jayinfinia/archibald-moteus/hw/c1-encoder-review/Bench-Test-Record.csv

Test ID | Status | Date | Tester | Board revision | Firmware commit | Encoder model | Protocol | Cable length mm | Termination | Setup and acceptance criteria | Measurements | Evidence file links | Reviewer | Notes
D01 | NOT RUN
D02 | NOT RUN
D03 | NOT RUN
D04 | NOT RUN
D05 | NOT RUN
D06 | NOT RUN
D07 | NOT RUN
B01 | NOT RUN
B02 | NOT RUN
B03 | NOT RUN
B04 | NOT RUN
B05 | NOT RUN
B06 | NOT RUN
B07 | NOT RUN
B08 | NOT RUN
B09 | NOT RUN
B10 | NOT RUN
B11 | NOT RUN
B12 | NOT RUN
