jayinfinia/archibald-moteus/hw/c1-encoder-review/Verification.txt

Verification: 2026-10-08
PASS: 12 interface connection groups match intended mapping.
PASS: battery positive connects only J2.7 and J3.1.
PASS: no duplicate component references.
PASS: stock AUX2 and AUX2H1 removed from schematic.
PASS: all electrical connections among components outside aux2 are unchanged.
PASS: all other child schematic files are byte-identical to the original.
baseline ERC: {'error': 28, 'warning': 91}; total 119
integrated ERC: {'error': 24, 'warning': 65}; total 89
PASS: zero reported ERC violations on integrated aux2 sheet.
NOT VERIFIED: physical footprints, cable contact orientation, loaded power budget, PCB layout, firmware, hardware behavior.
ERC counts are not directly comparable for footprint warnings: baseline library resolution differs from the self-contained output copy. Existing C1 violations remain.
