jayinfinia/archibald-moteus/hw/c1-encoder-review/Complete-C1-Schematic.pdf

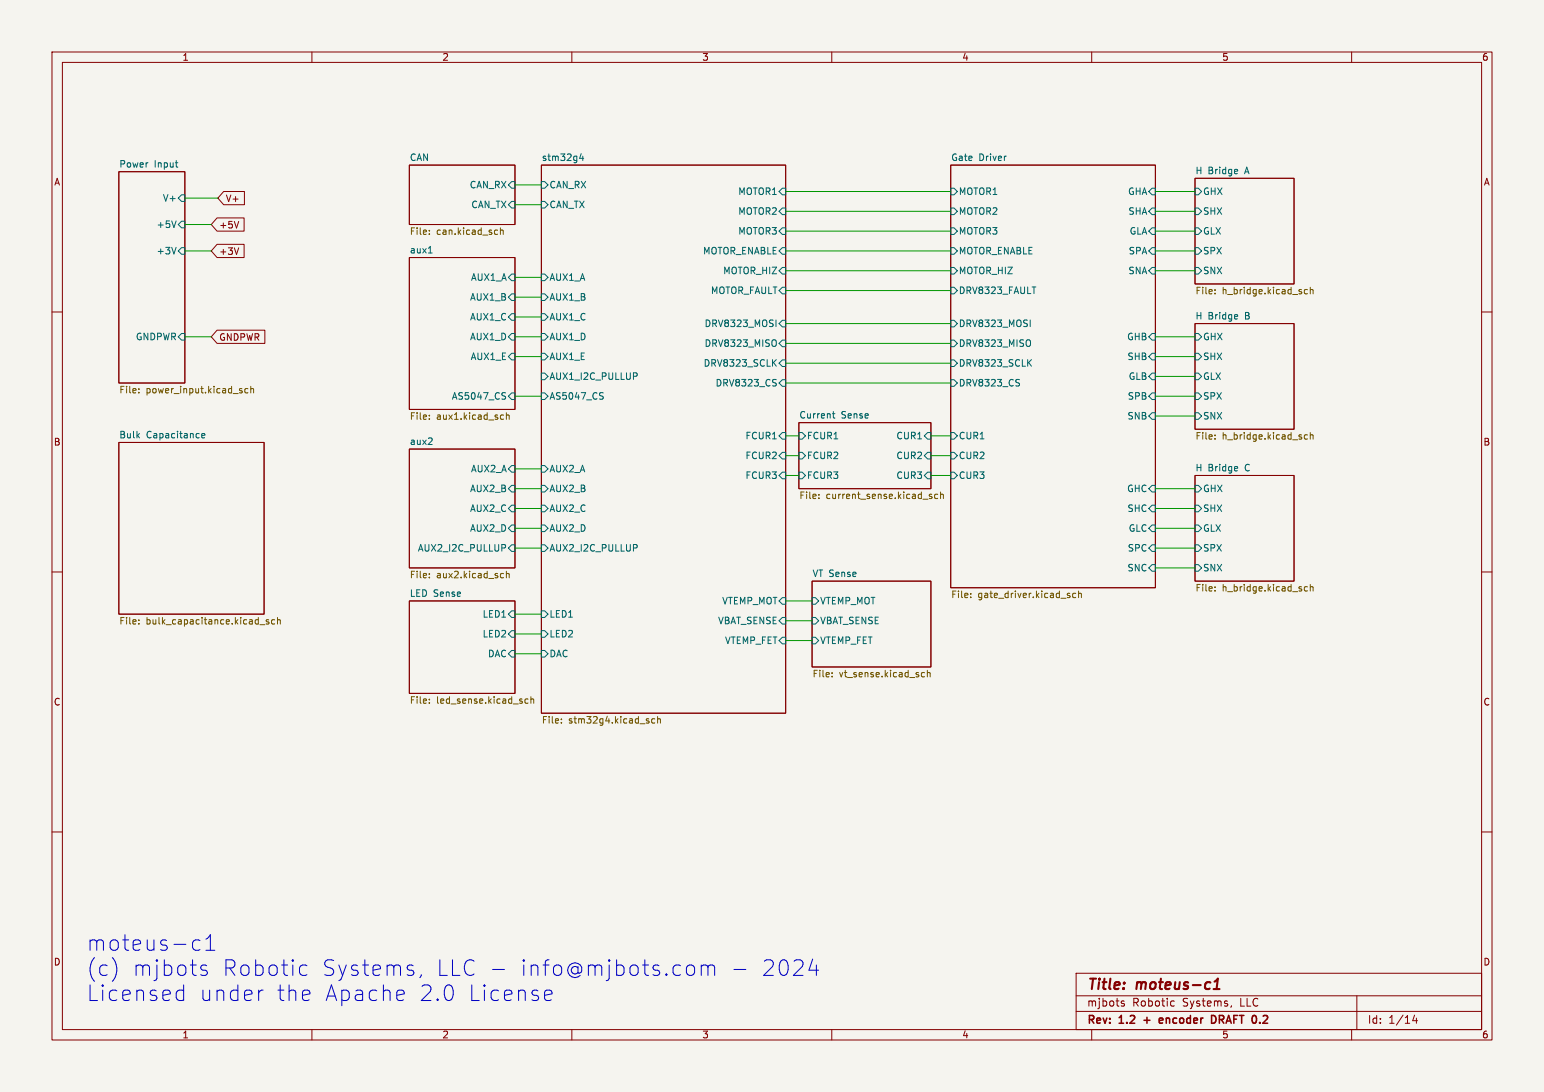
[picture p1: page 1]

Power Input File: power_input.kicad_sch +3V GNDPWR

Licensed under the Apache 2.0 License

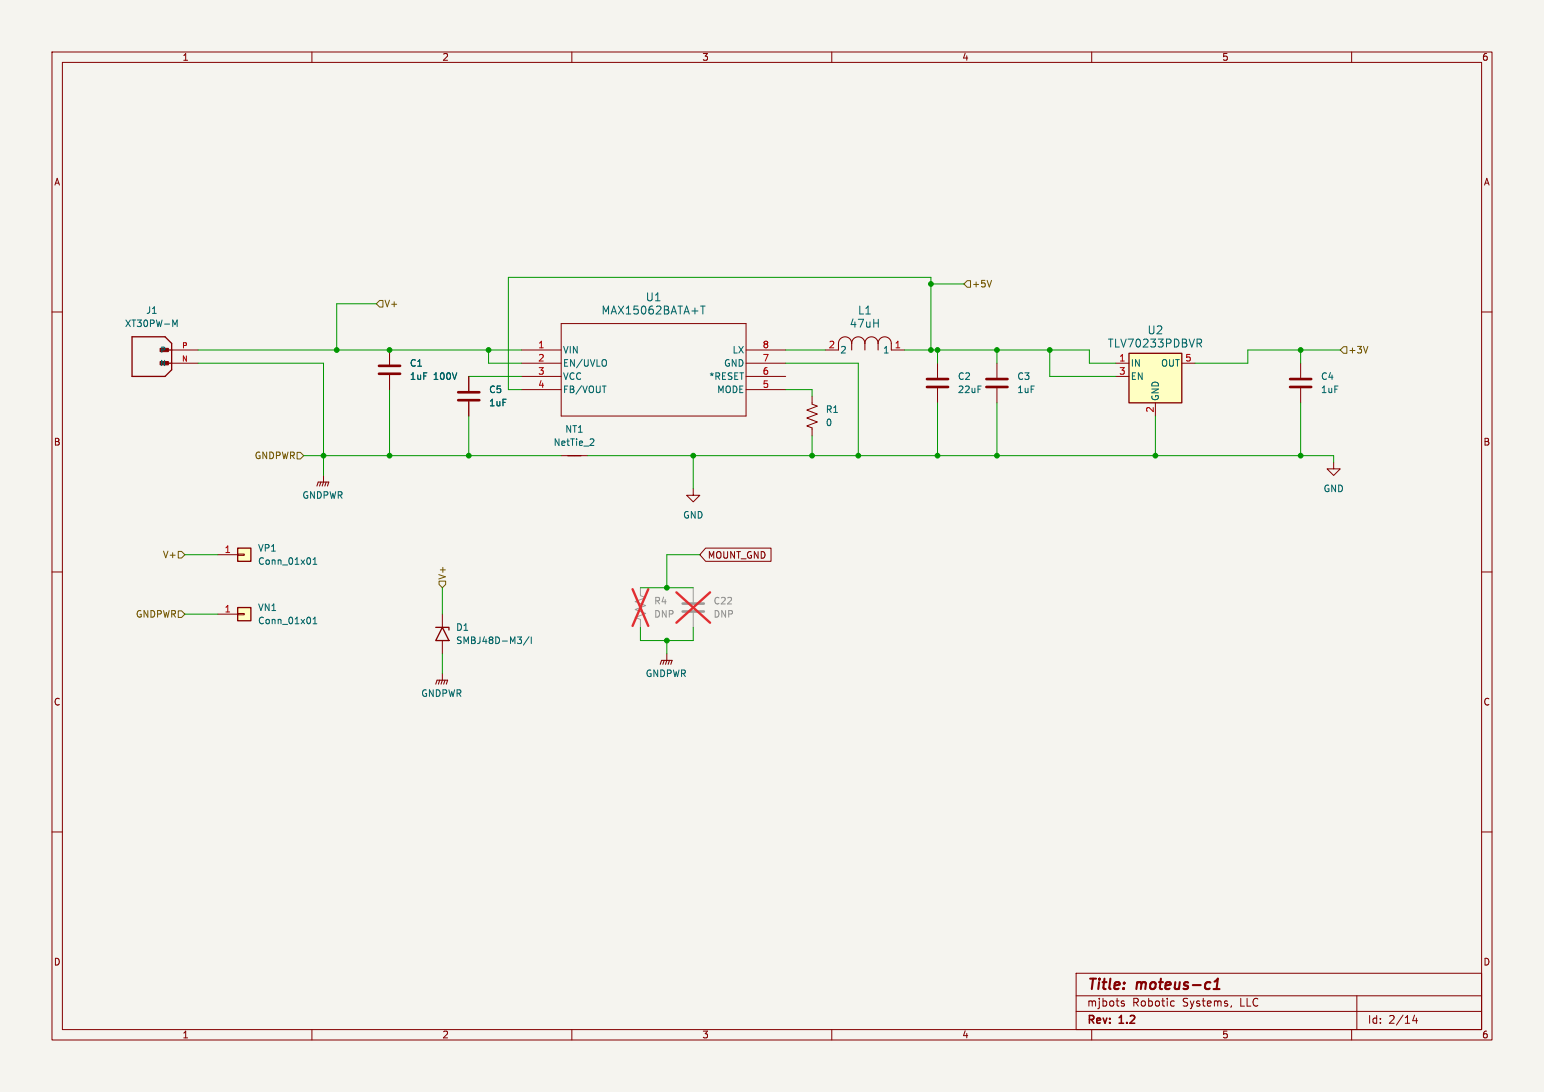
[picture p2: page 2]

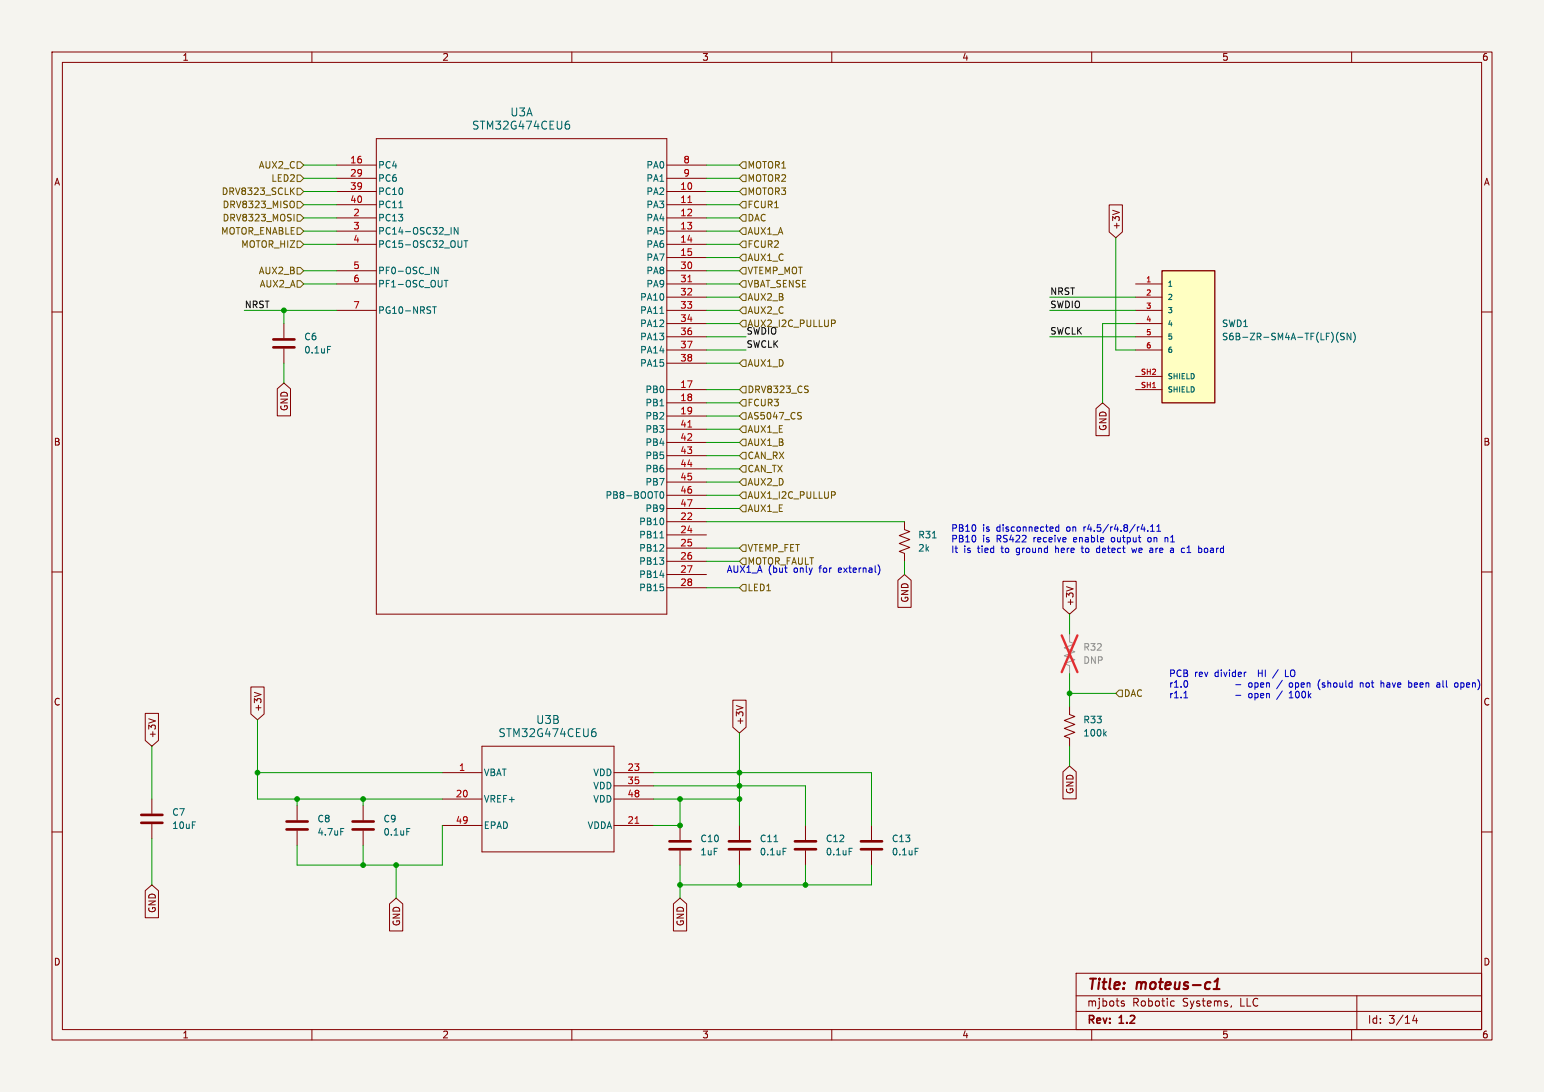
[picture p3: page 3]

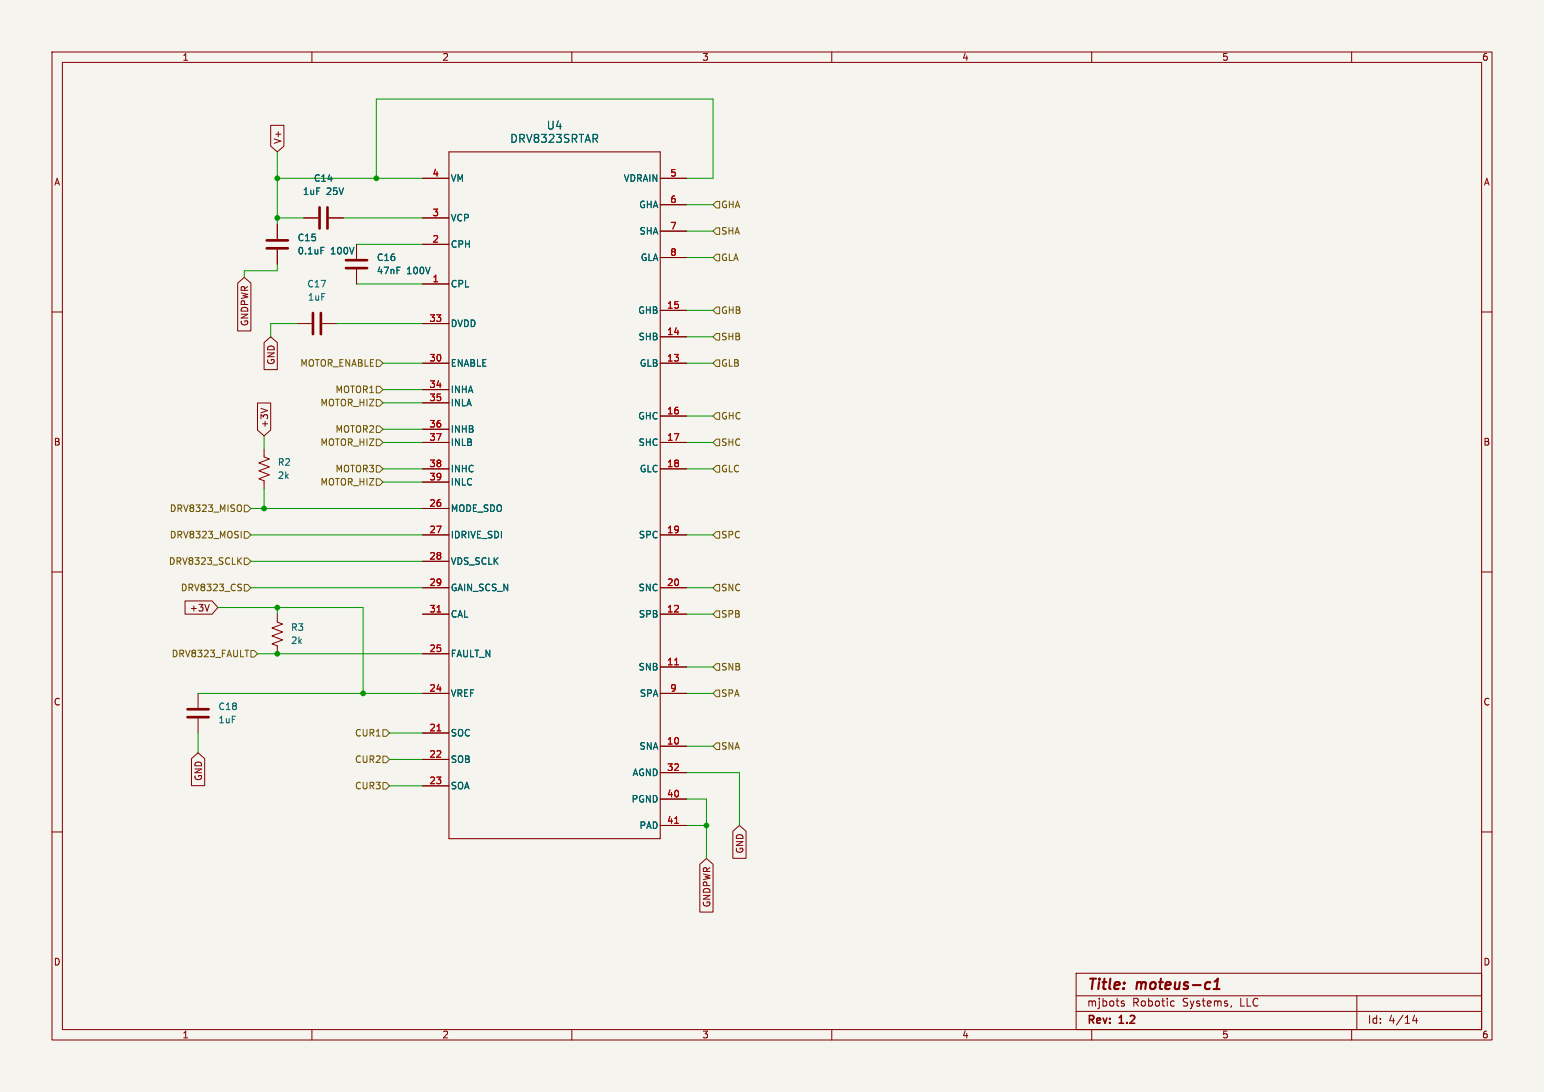
[picture p4: page 4]

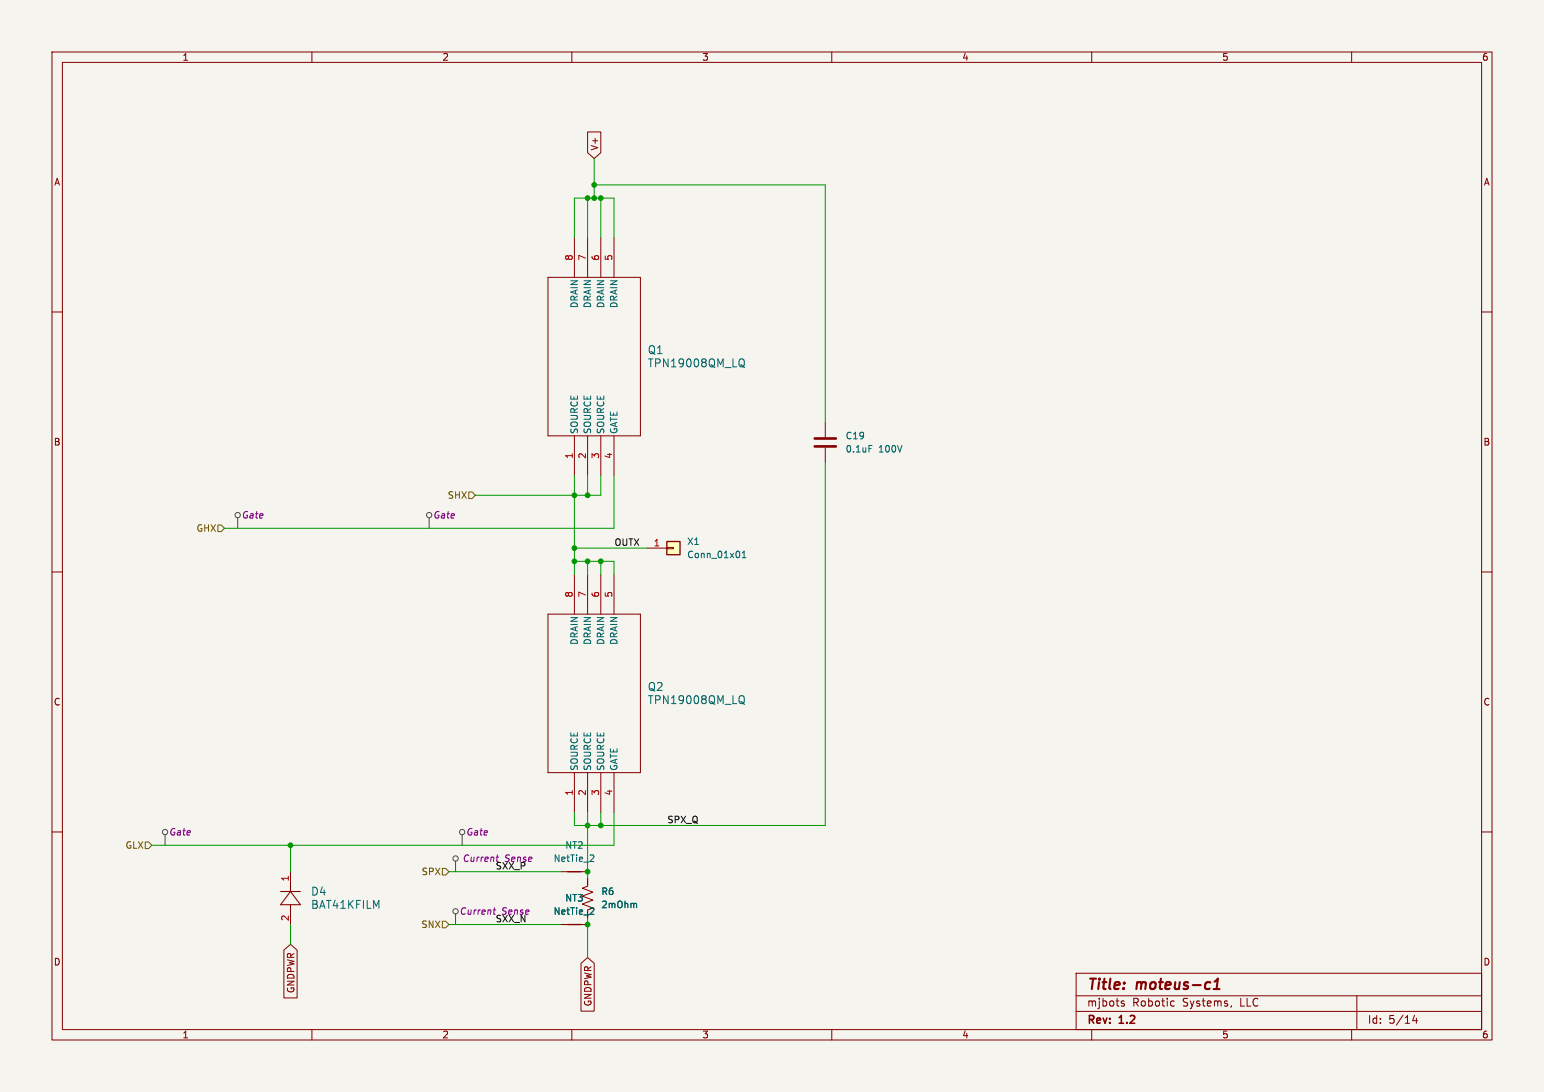
[picture p5: page 5]

2 1 D4BAT41KFILM Current Sense Current Sense Gate Gate Gate Gate SPX

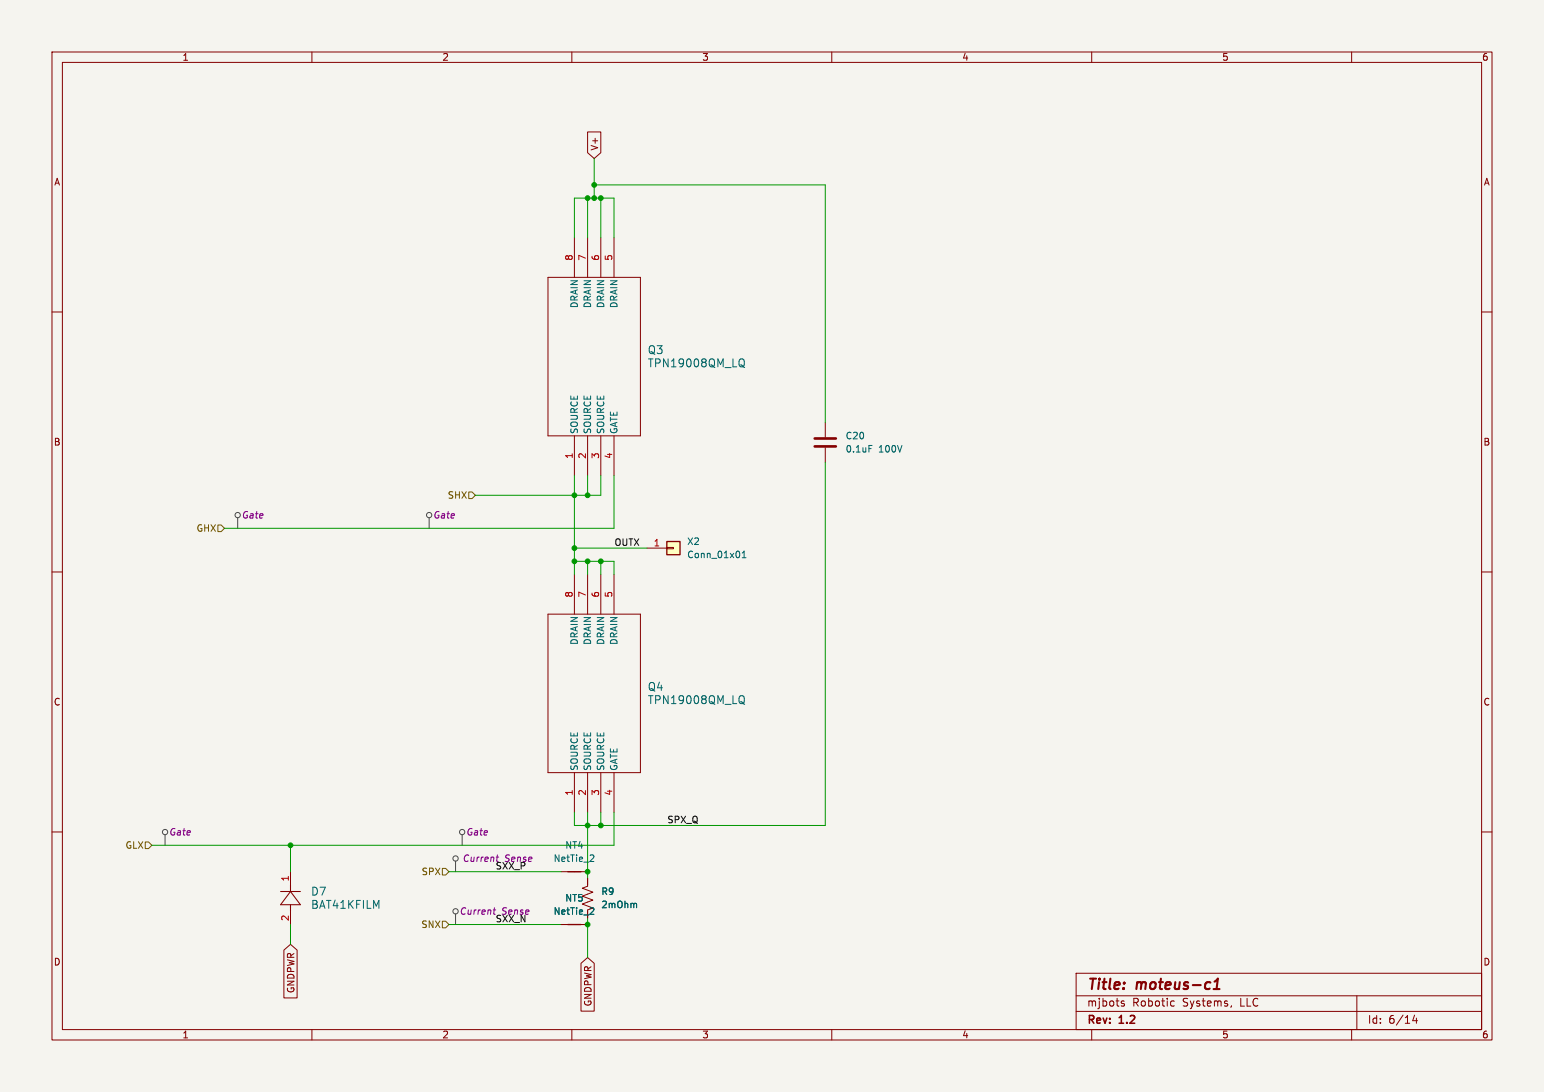
[picture p6: page 6]

2 1 D7BAT41KFILM Current Sense Current Sense Gate Gate Gate Gate SPX

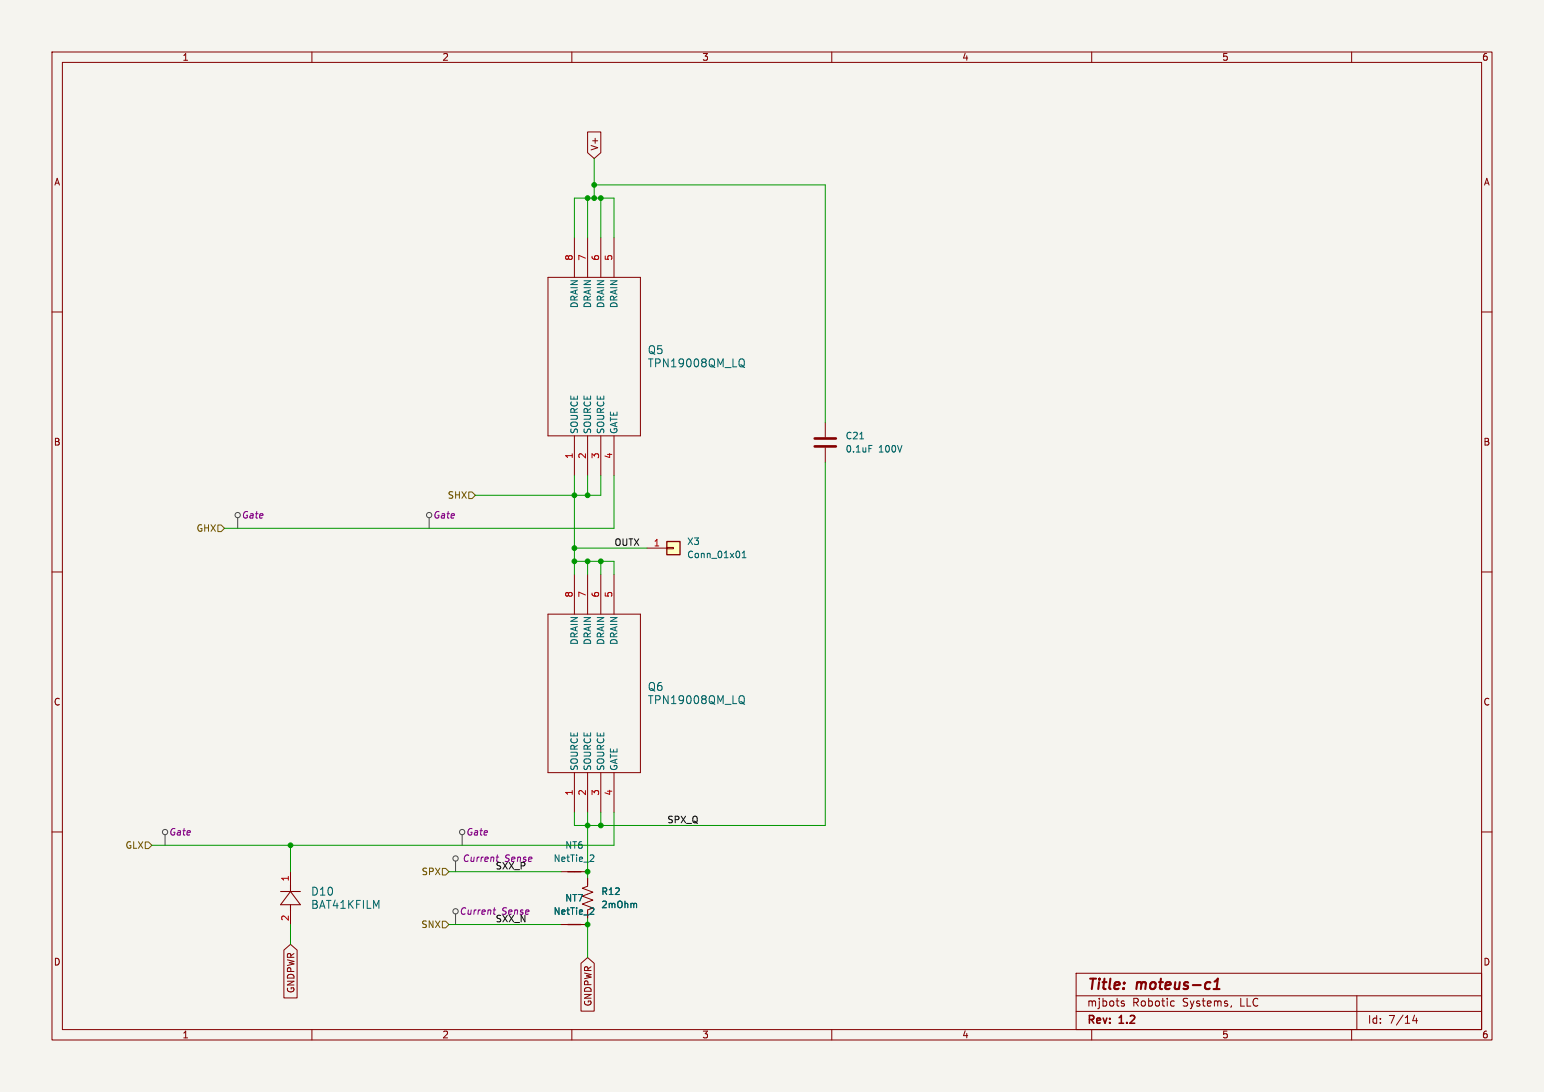
[picture p7: page 7]

2 1 D10 BAT41KFILM Current Sense Current Sense Gate Gate Gate Gate SPX

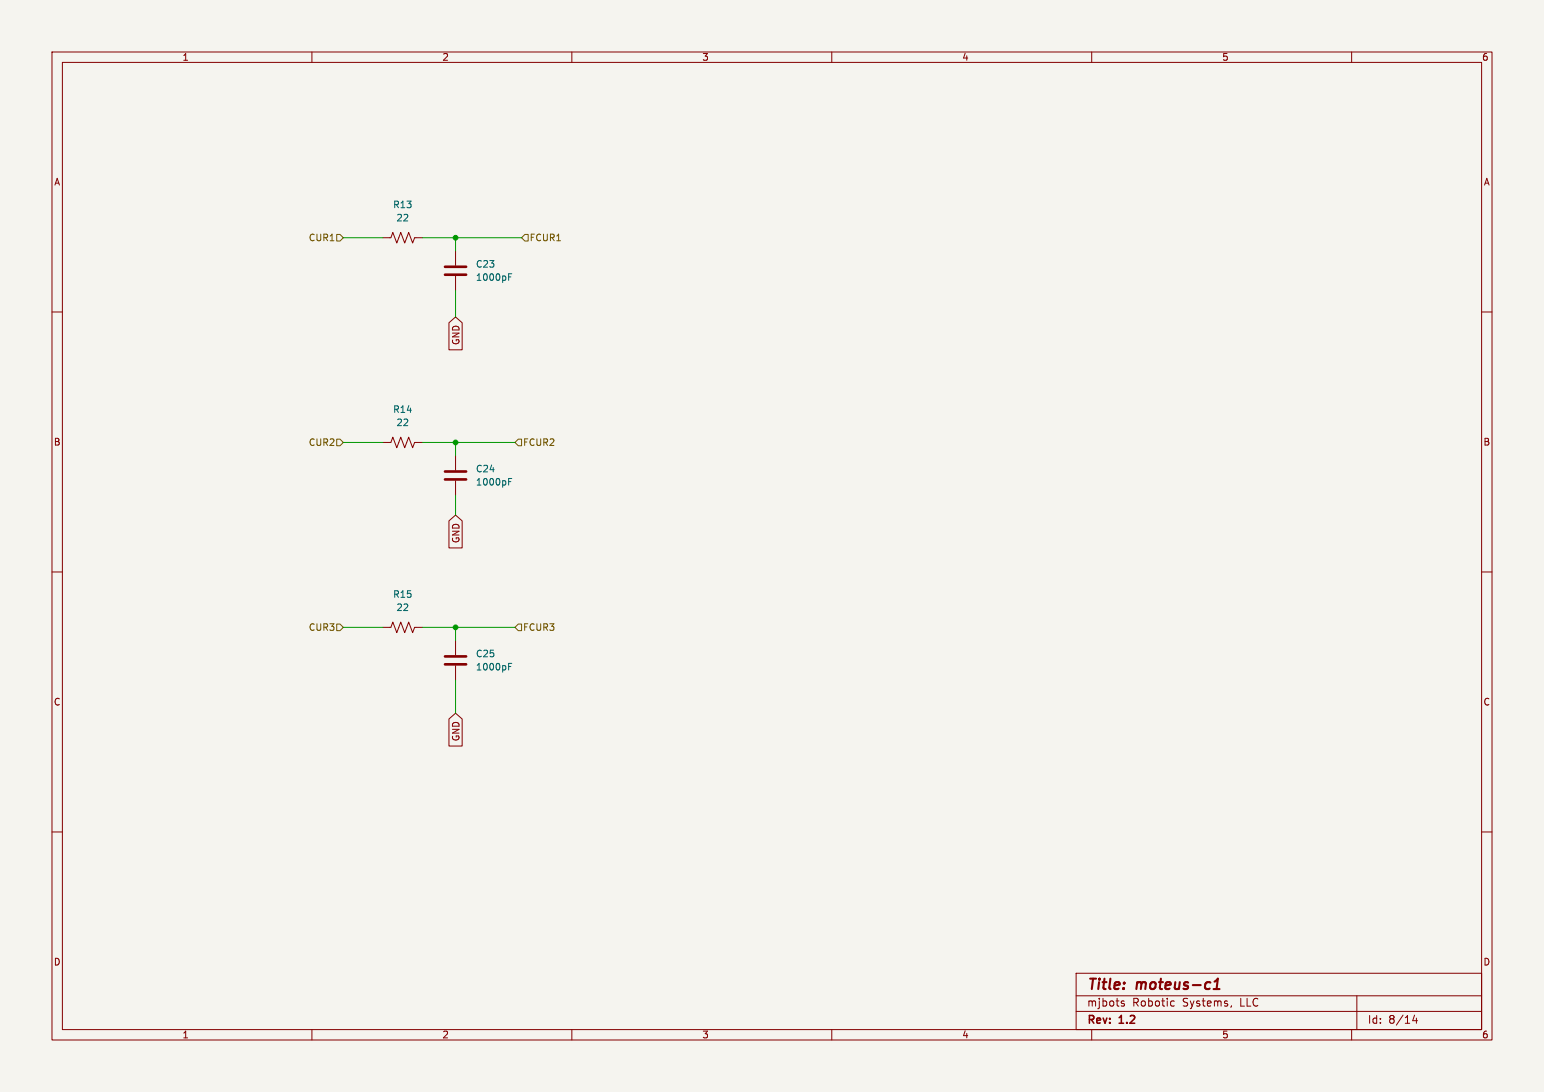
[picture p8: page 8]

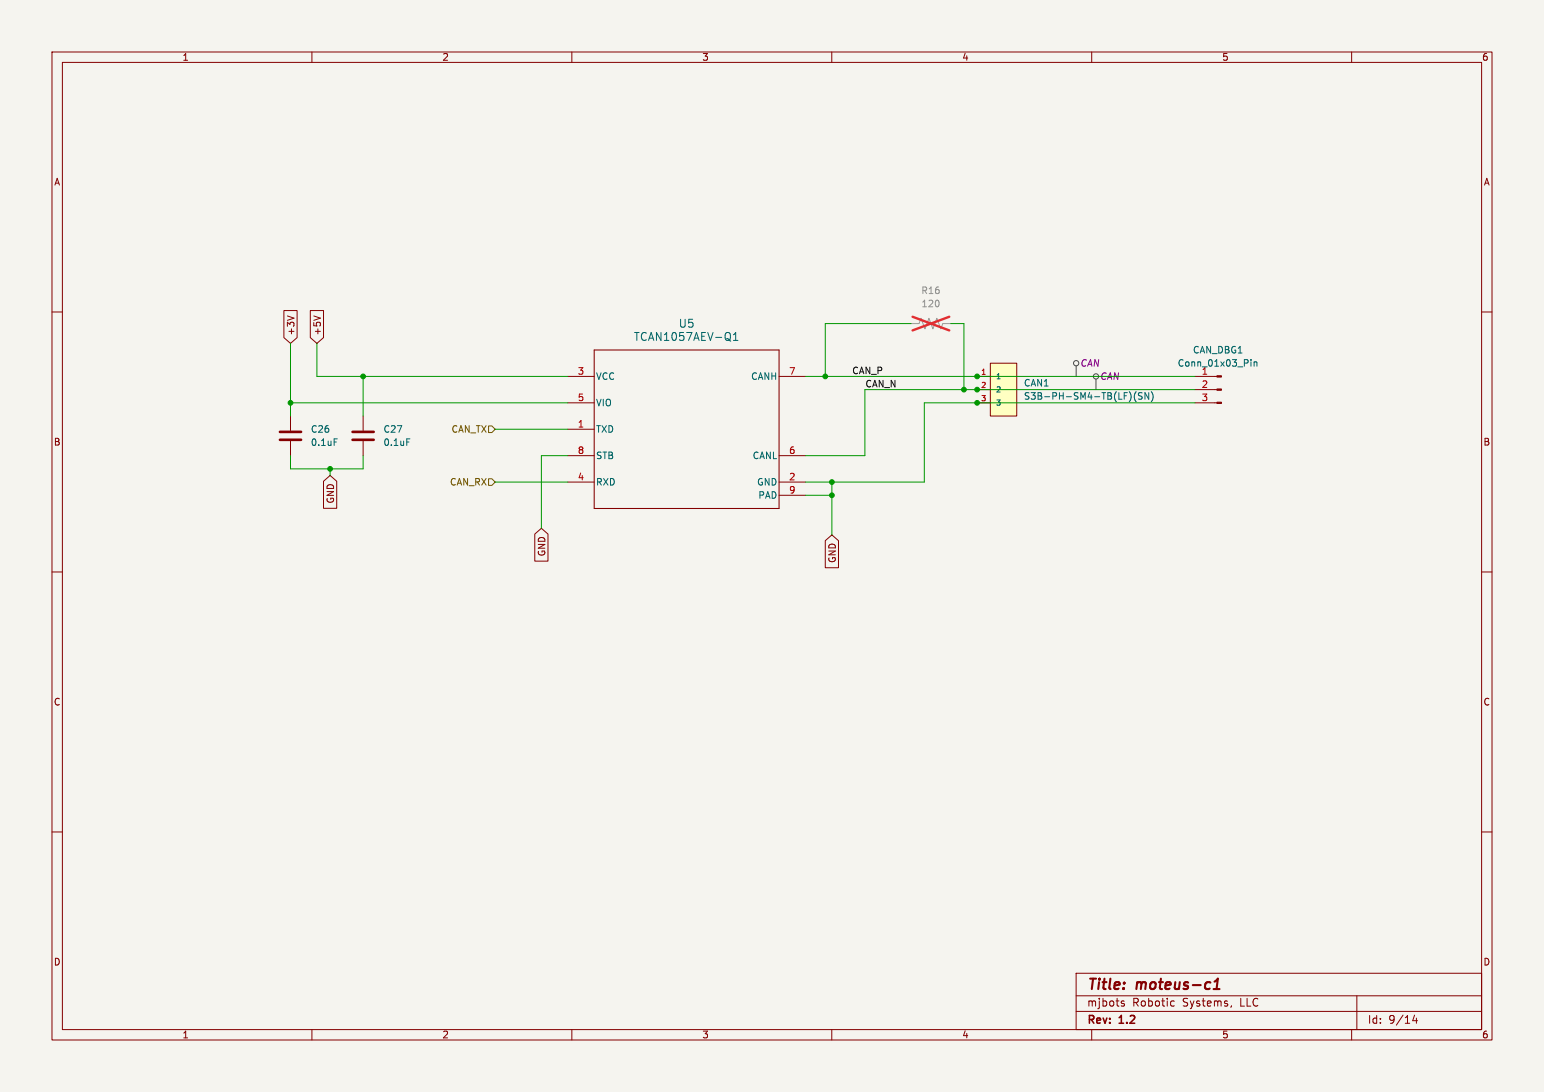
[picture p9: page 9]

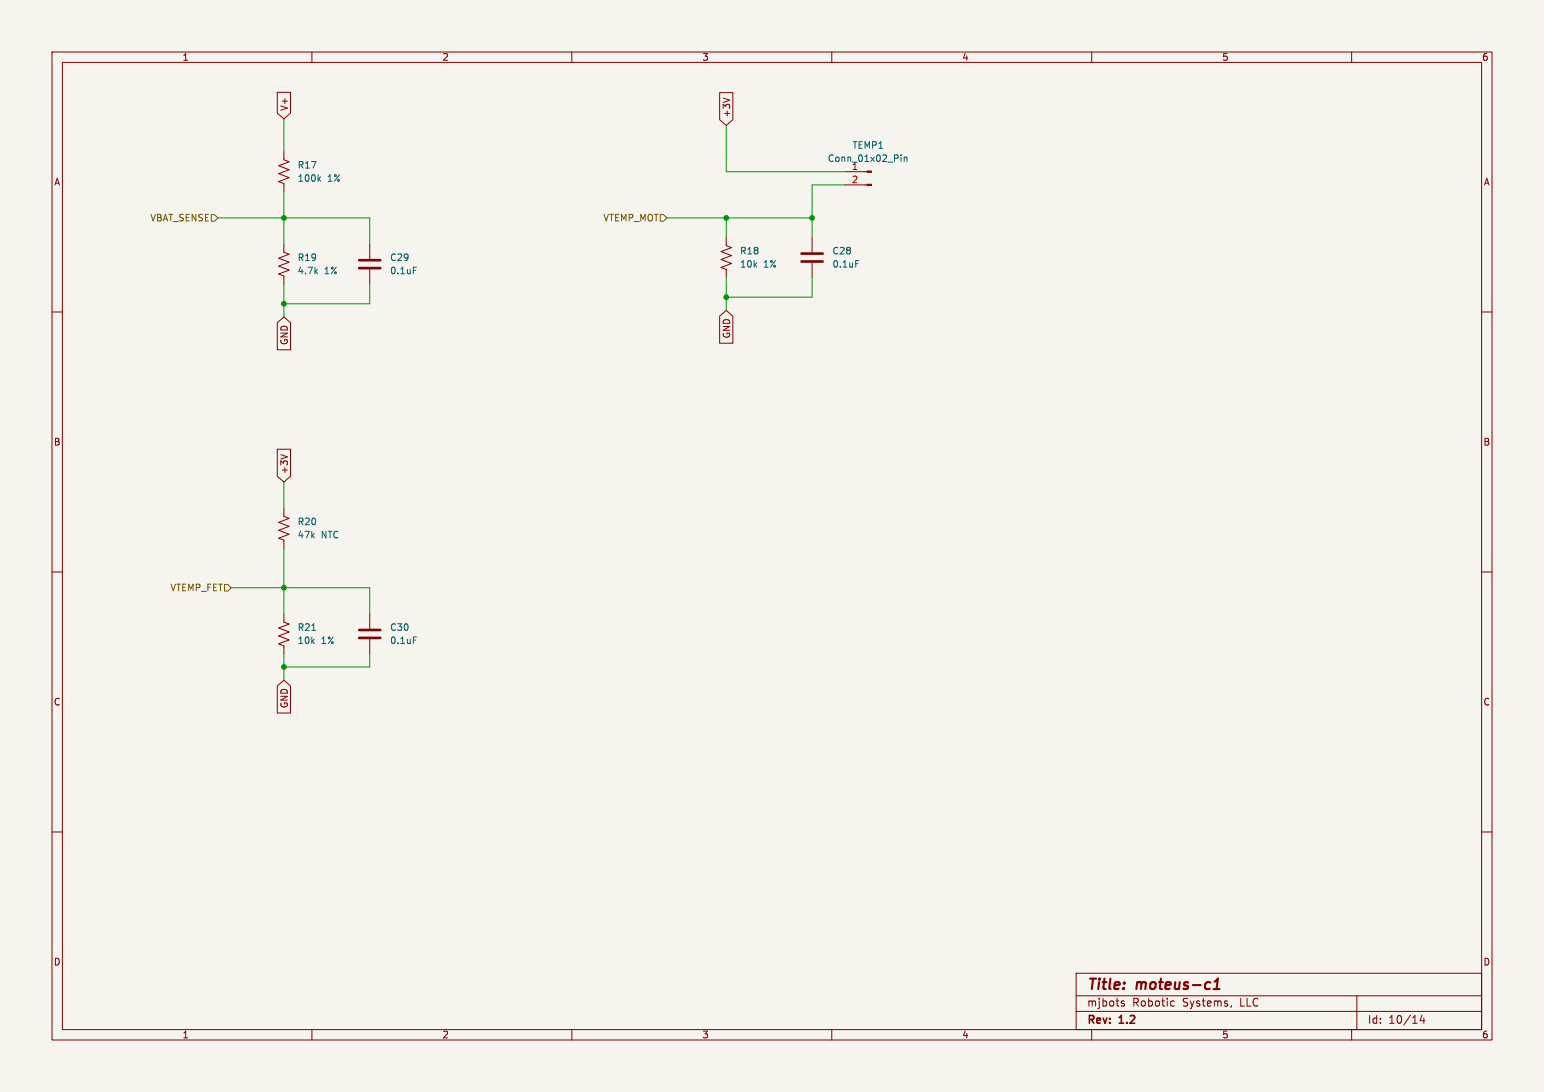
[picture p10: page 10]

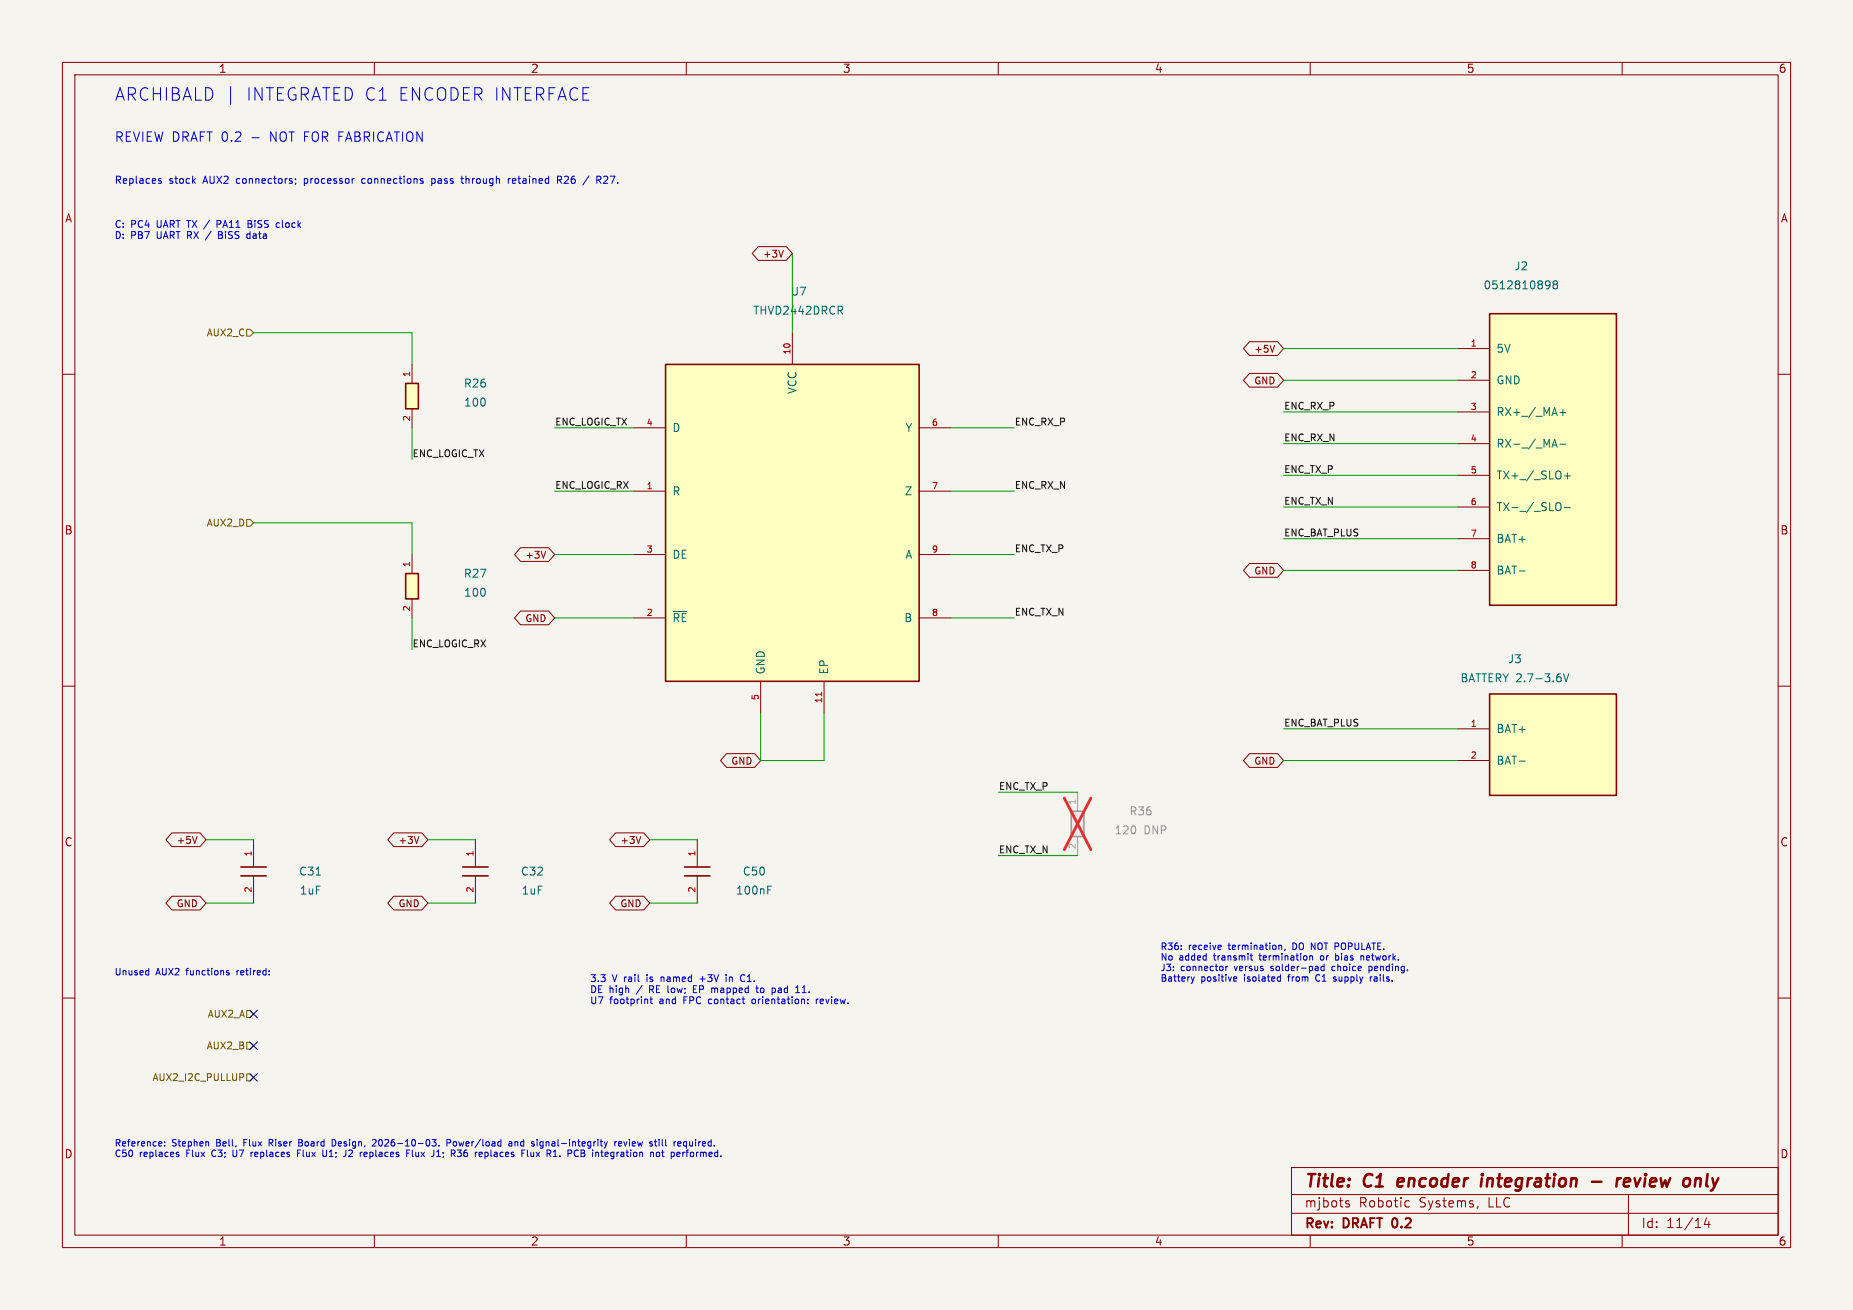
[picture p11: page 11]

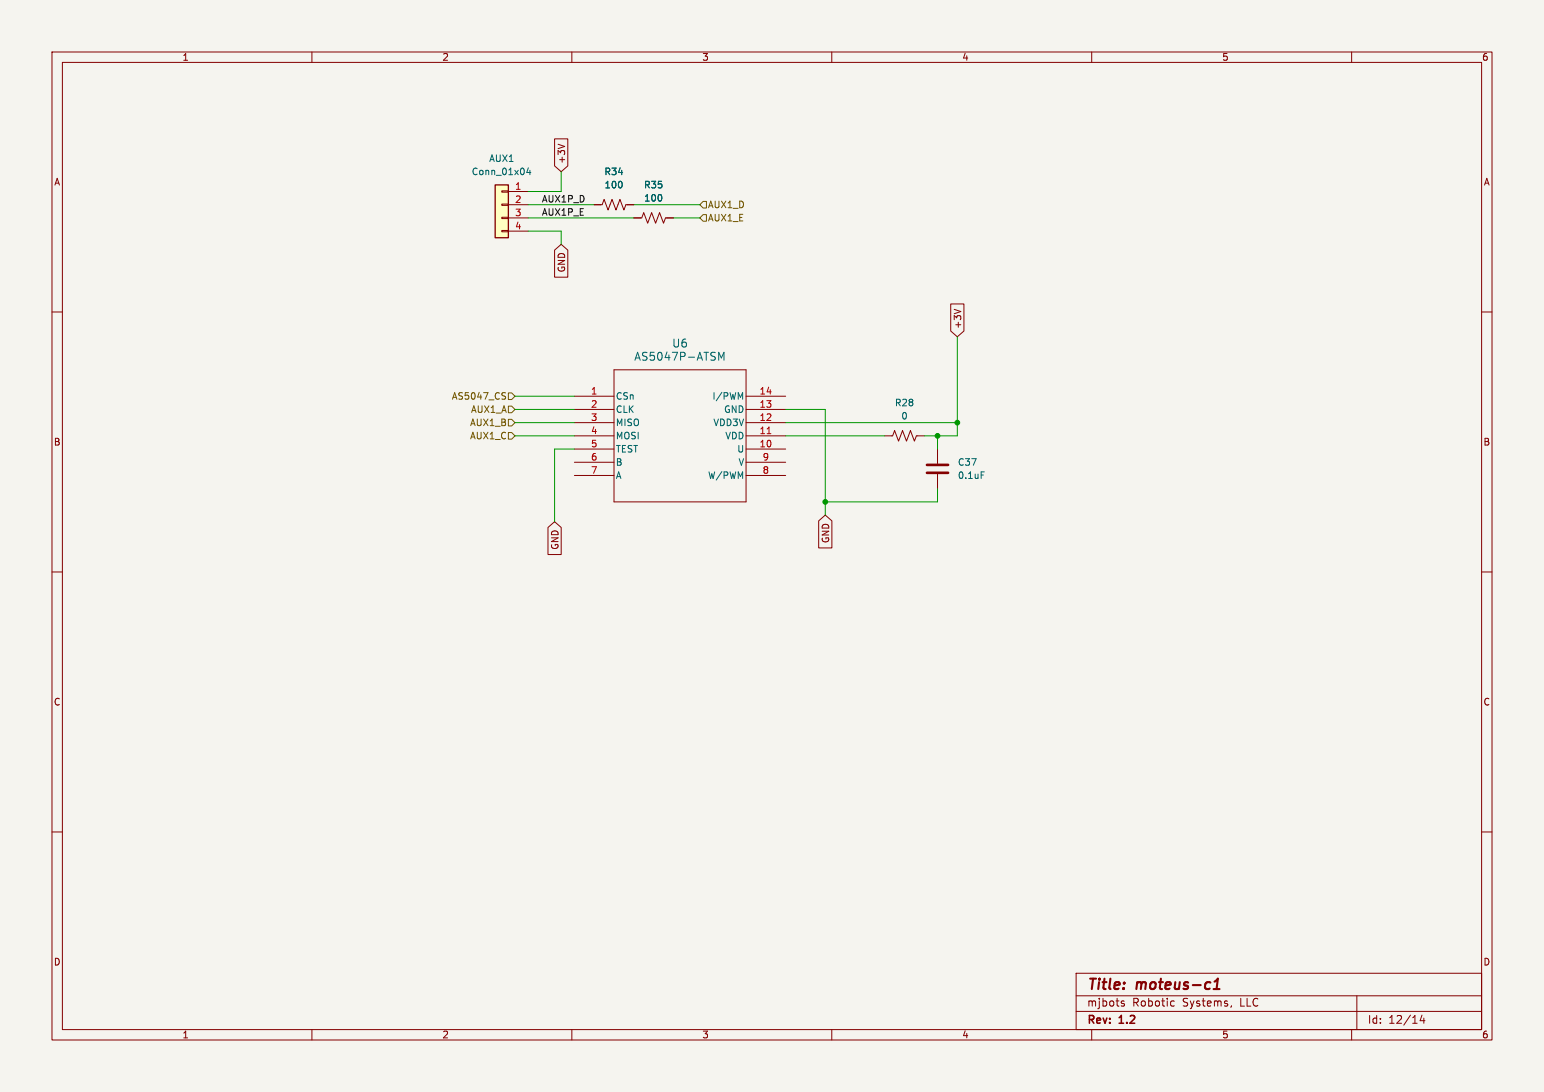
[picture p12: page 12]

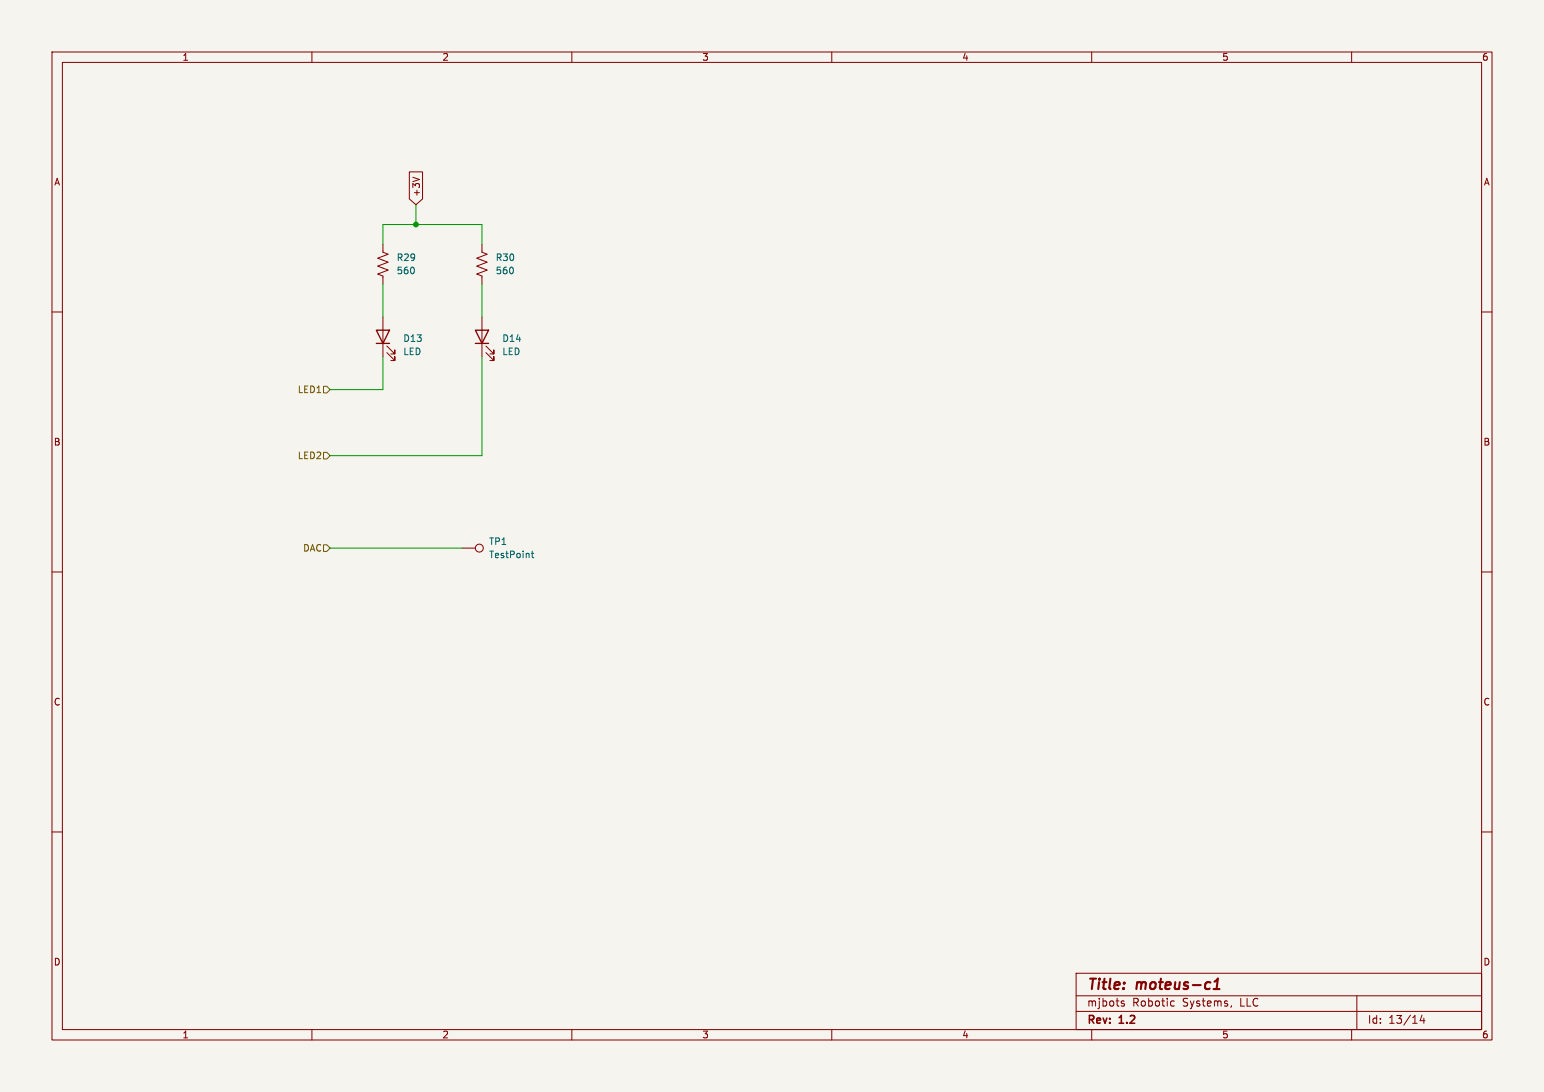
[picture p13: page 13]

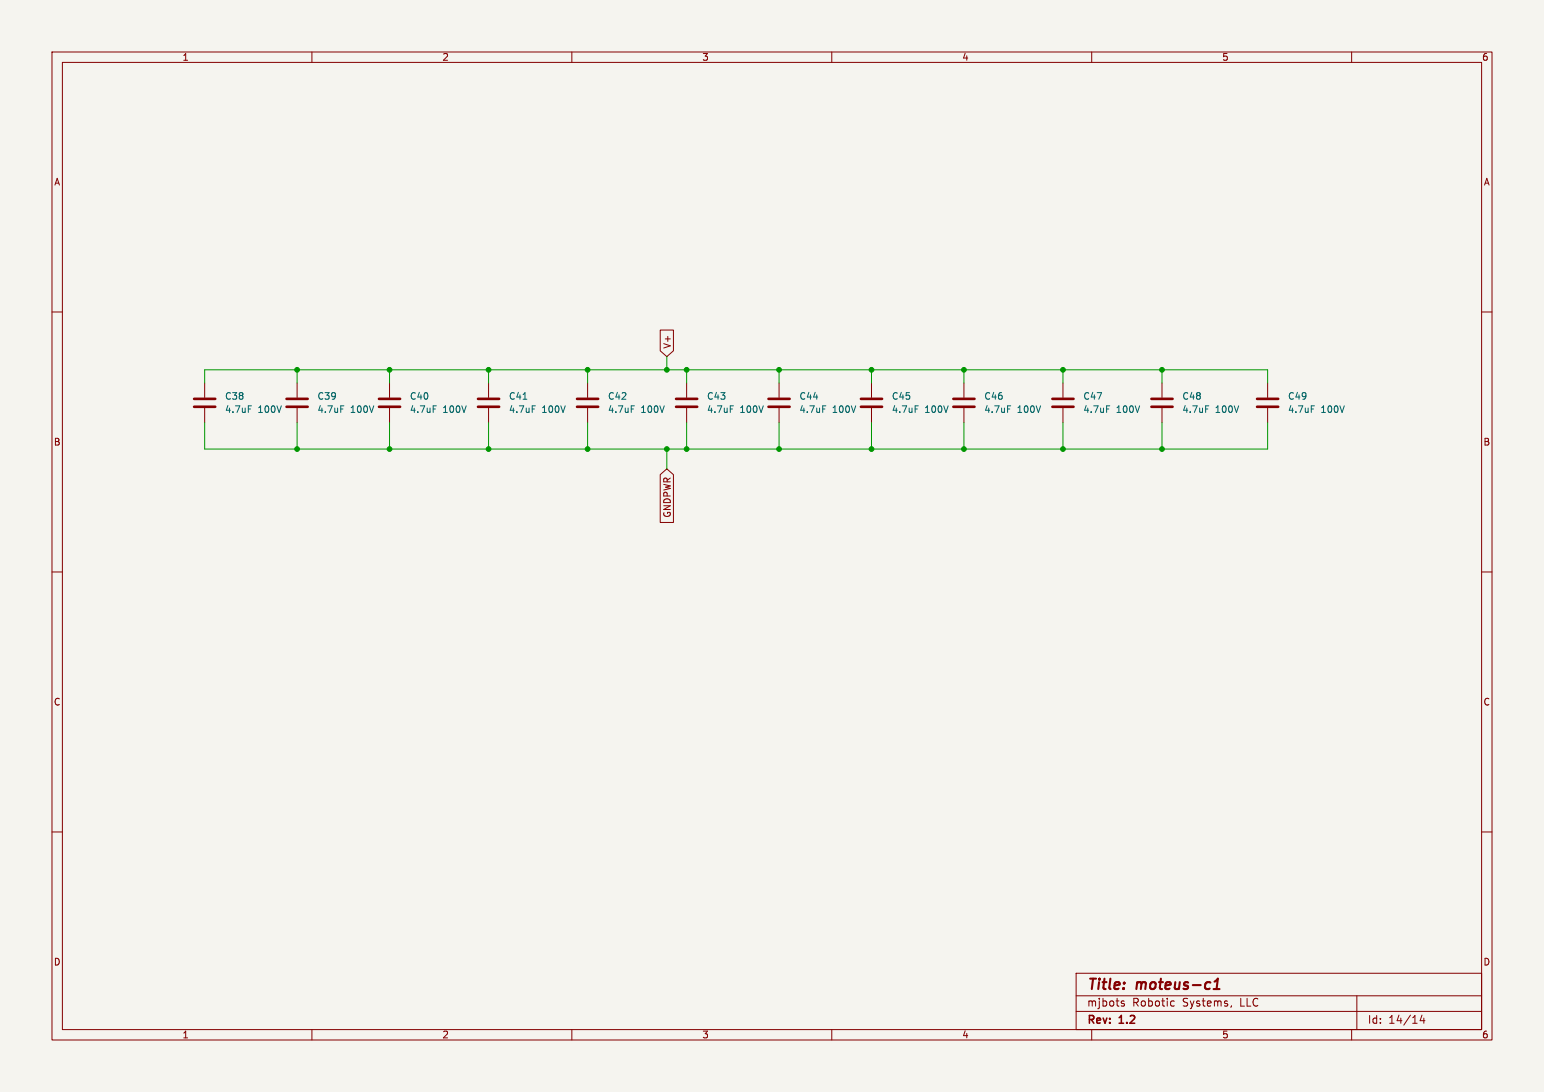
[picture p14: page 14]
