jayinfinia/archibald-moteus/hw/c1-encoder-review/aux1.kicad_sch

## KiCad design hw/c1-encoder-review/aux1.kicad_sch (2026-10-09)

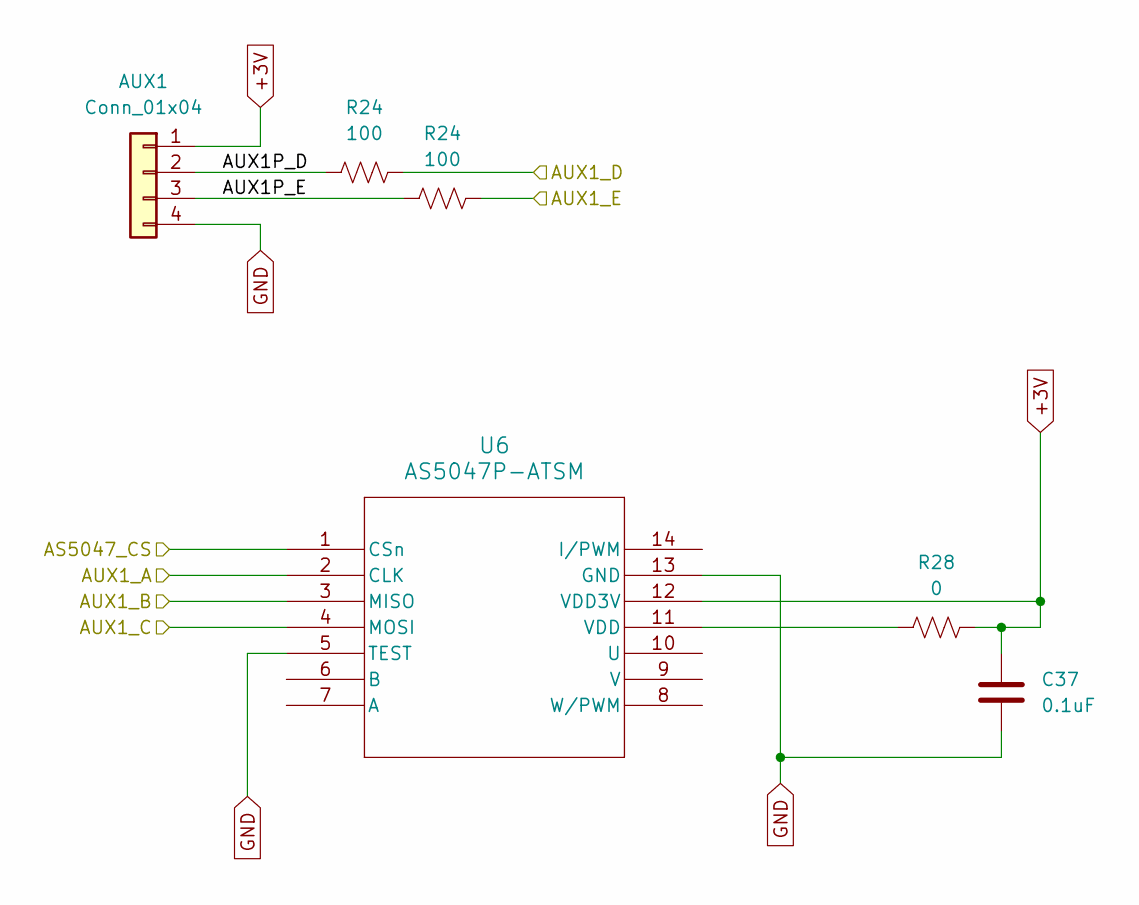
[picture p15: schematic aux1.kicad_sch]

Parts:
AUX1: Conn_01x04; PinHeader_1x04_P1.27mm_Vertical
C37: 0.1uF; C_0402_1005Metric; MPN MF-CAP-0402-0.1uF
R24: 100; R_0402_1005Metric; MPN MF-RES-0402-100
R28: 0; R_0402_1005Metric; MPN MF-RES-0402-0
U6: AS5047P-ATSM; TSSOP14_OSM; MPN AS5047P-ATSM

Connections:
+3V: AUX1.1, C37.1, R28.2, U6.12 (VDD3V)
AS5047_CS: U6.1 (CSn)
AUX1P_D: AUX1.2, R24.1
AUX1P_E: AUX1.3, R24.1
AUX1_A: U6.2 (CLK)
AUX1_B: U6.3 (MISO)
AUX1_C: U6.4 (MOSI)
AUX1_D: R24.2
AUX1_E: R24.2
GND: AUX1.4, C37.2, U6.5 (TEST), U6.13 (GND)
unnamed: R28.1, U6.11 (VDD)
