jayinfinia/archibald-moteus/hw/c1-encoder-review/aux2.kicad_sch

## KiCad design hw/c1-encoder-review/aux2.kicad_sch (2026-10-19)

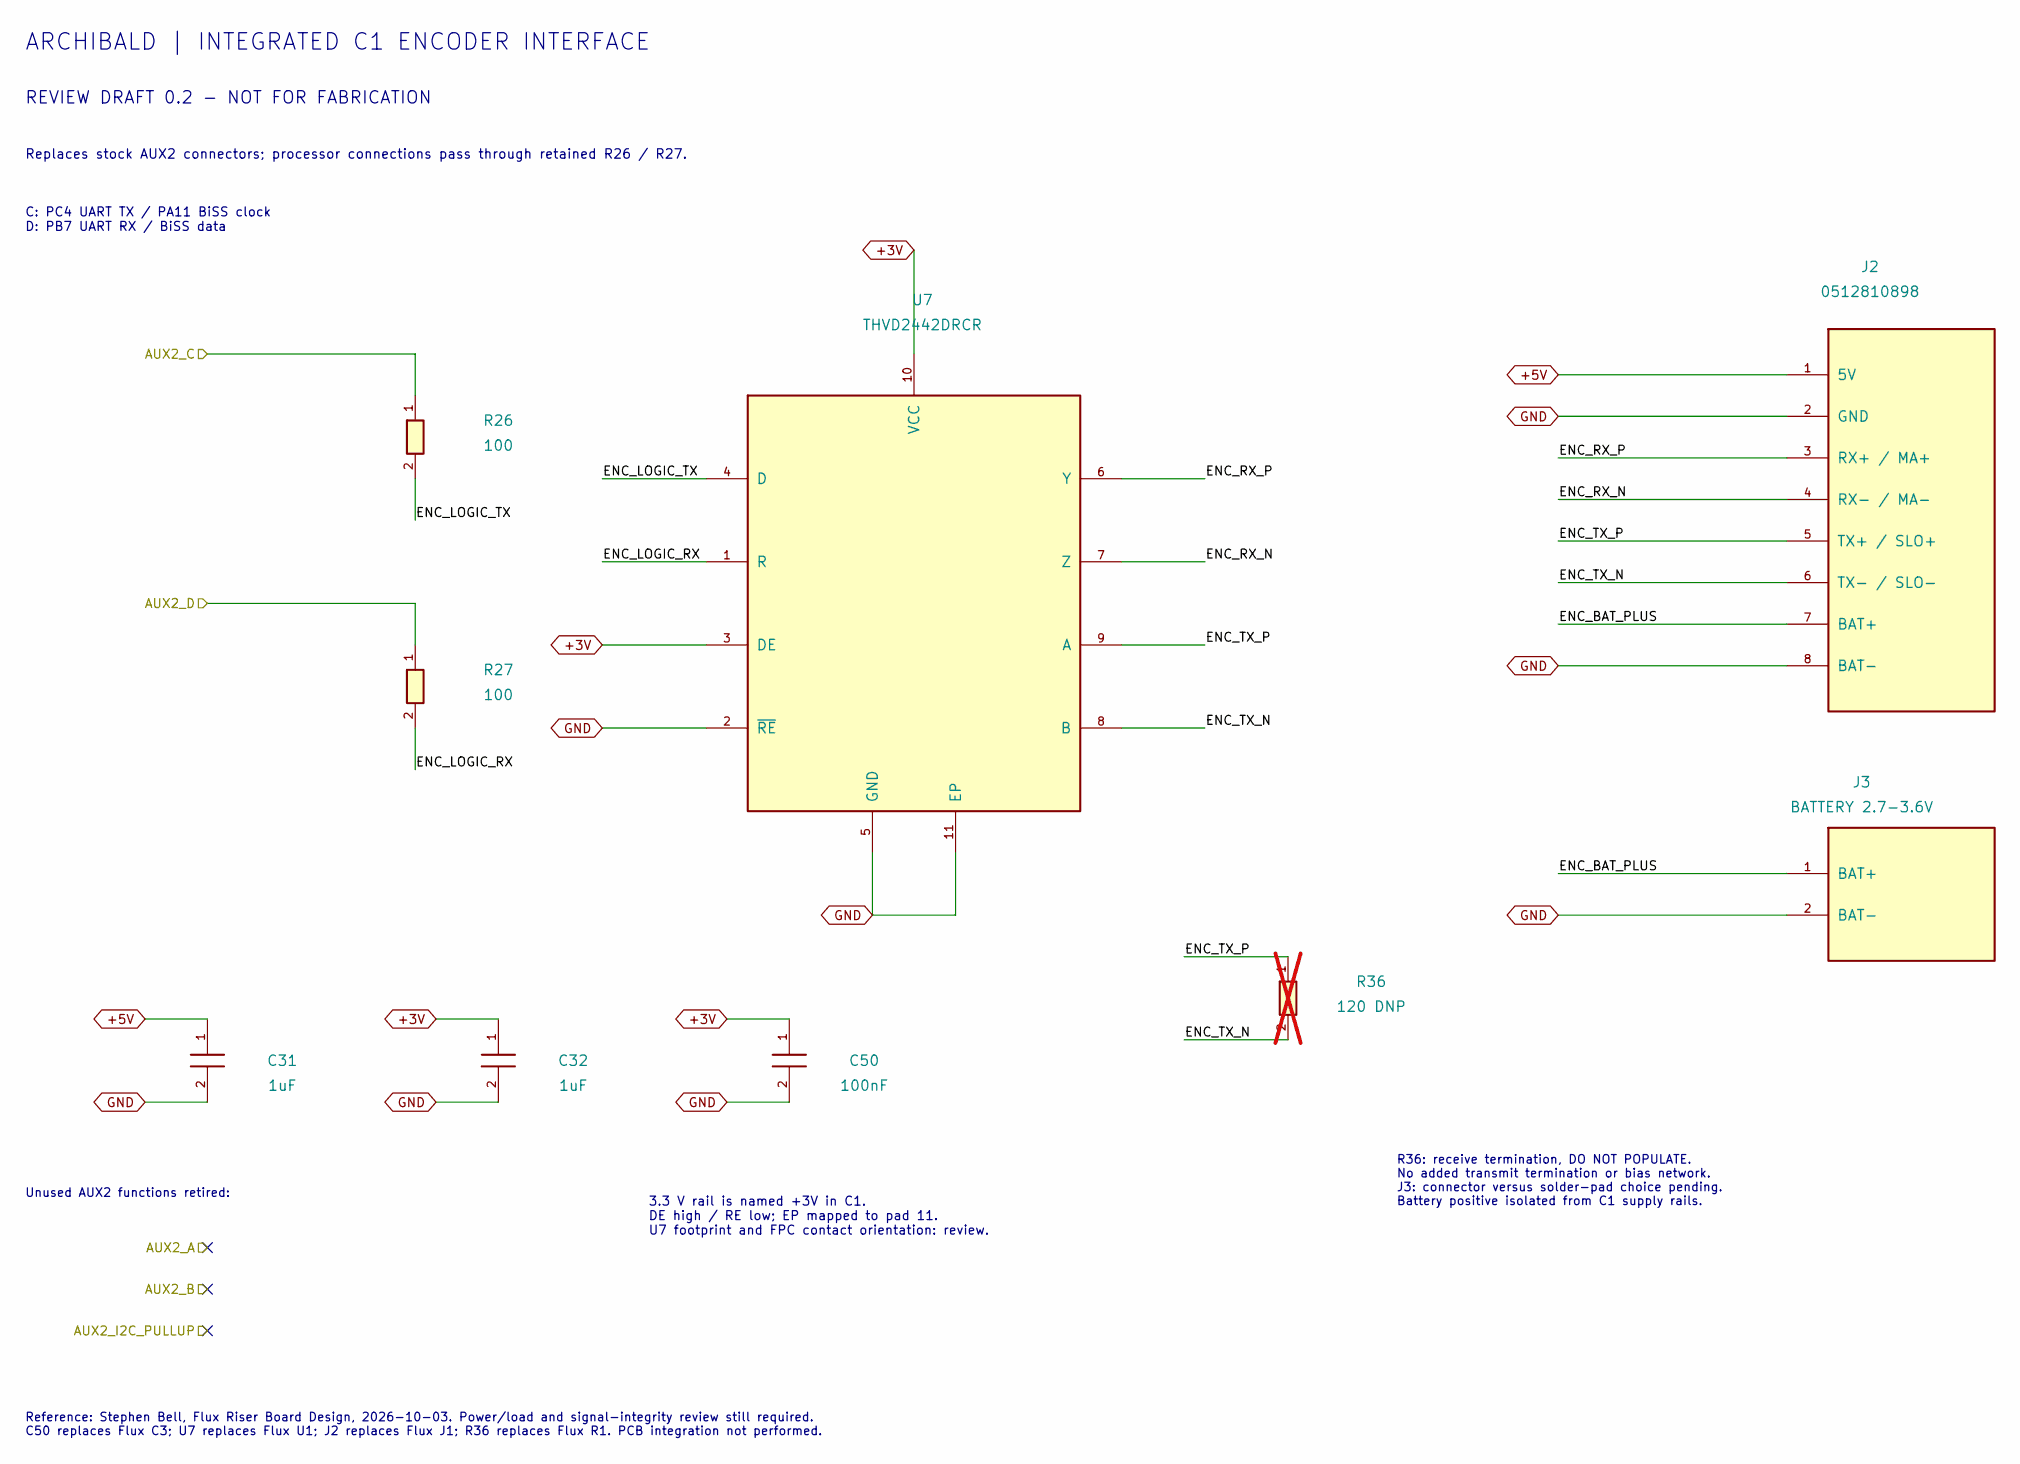
[picture p16: schematic aux2.kicad_sch]

Parts:
C31, C32: 1uF; C_0402_1005Metric
C50: 100nF; C_0402_1005Metric; MPN GRM155R61A104KA01D
J2: 0512810898; MPN 0512810898
J3: BATTERY 2.7-3.6V
R26, R27: 100; R_0402_1005Metric
R36: 120 DNP; R_0402_1005Metric; MPN RC0402FR-07120RL; not fitted
U7: THVD2442DRCR; TI_DRC0010J; MPN THVD2442DRCR

Connections:
+3V: C32.1, C50.1, U7.3 (DE), U7.10 (VCC)
+5V: C31.1, J2.1 (5V)
AUX2_C: R26.1
AUX2_D: R27.1
ENC_BAT_PLUS: J2.7 (BAT+), J3.1 (BAT+)
ENC_LOGIC_RX: R27.2, U7.1 (R)
ENC_LOGIC_TX: R26.2, U7.4 (D)
ENC_RX_N: J2.4 (RX- / MA-), U7.7 (Z)
ENC_RX_P: J2.3 (RX+ / MA+), U7.6 (Y)
ENC_TX_N: J2.6 (TX- / SLO-), R36.2, U7.8 (B)
ENC_TX_P: J2.5 (TX+ / SLO+), R36.1, U7.9 (A)
GND: C31.2, C32.2, C50.2, J2.2 (GND), J2.8 (BAT-), J3.2 (BAT-), U7.2 (~RE), U7.5 (GND), U7.11 (EP)

Notes on the sheet:
ARCHIBALD | INTEGRATED C1 ENCODER INTERFACE
REVIEW DRAFT 0.2 - NOT FOR FABRICATION
Replaces stock AUX2 connectors; processor connections pass through retained R26 / R27.
C: PC4 UART TX / PA11 BiSS clock D: PB7 UART RX / BiSS data
3.3 V rail is named +3V in C1. DE high / RE low; EP mapped to pad 11. U7 footprint and FPC contact orientation: review.
R36: receive termination, DO NOT POPULATE. No added transmit termination or bias network. J3: connector versus solder-pad choice pending. Battery positive isolated from C1 supply rails.
Unused AUX2 functions retired:
Reference: Stephen Bell, Flux Riser Board Design, 2026-10-03. Power/load and signal-integrity review still required. C50 replaces Flux C3; U7 replaces Flux U1; J2 replaces Flux J1; R36 replaces Flux R1. PCB integration not performed.
