jayinfinia/archibald-moteus/hw/c1-encoder-review/bulk_capacitance.kicad_sch

## KiCad design hw/c1-encoder-review/bulk_capacitance.kicad_sch (2026-10-09)

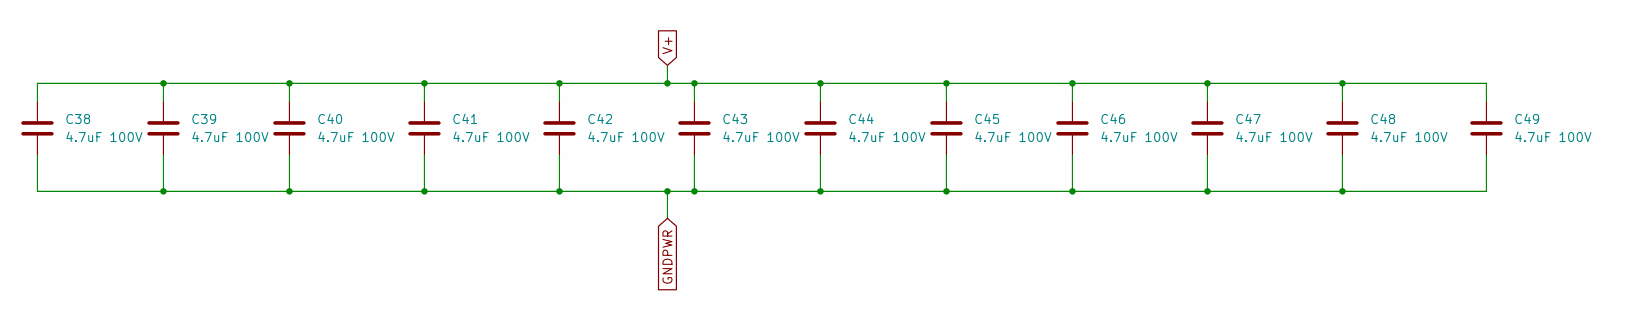
[picture p17: schematic bulk_capacitance.kicad_sch]

Parts:
C38, C39, C40, C41, C42, C43, C44, C45, C46, C47, C48, C49: 4.7uF 100V; C_1206_3216Metric; MPN GRJ31CC72A475KE01K

Connections:
GNDPWR: C38.2, C39.2, C40.2, C41.2, C42.2, C43.2, C44.2, C45.2, C46.2, C47.2, C48.2, C49.2
V+: C38.1, C39.1, C40.1, C41.1, C42.1, C43.1, C44.1, C45.1, C46.1, C47.1, C48.1, C49.1
