jayinfinia/archibald-moteus/hw/c1-encoder-review/can.kicad_sch

## KiCad design hw/c1-encoder-review/can.kicad_sch (2026-10-09)

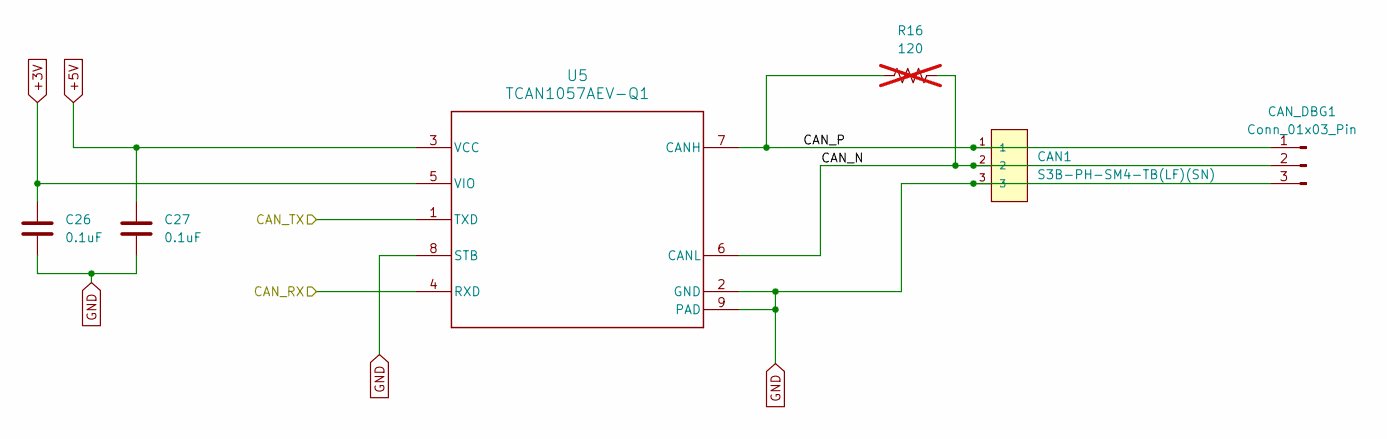
[picture p18: schematic can.kicad_sch]

Parts:
C26, C27: 0.1uF; C_0402_1005Metric; MPN MF-CAP-0402-0.1uF
CAN1: S3B-PH-SM4-TB(LF)(SN); JST_S3B-PH-SM4-TB(LF)(SN); MPN S3B-PH-SM4-TB(LF)(SN)
CAN_DBG1: Conn_01x03_Pin; PinHeader_1x03_P2.00mm_Vertical
R16: 120; R_0603_1608Metric; MPN RC0805FR-07120RL; not fitted
U5: TCAN1057AEV-Q1; SOIC-8_3.9x4.9mm_P1.27mm; MPN TCAN1057AEVDRQ1

Connections:
+3V: C26.1, U5.5 (VIO)
+5V: C27.1, U5.3 (VCC)
CAN_N: CAN1.2, CAN_DBG1.2, R16.2, U5.6 (CANL)
CAN_P: CAN1.1, CAN_DBG1.1, R16.1, U5.7 (CANH)
CAN_RX: U5.4 (RXD)
CAN_TX: U5.1 (TXD)
GND: C26.2, C27.2, CAN1.3, CAN_DBG1.3, U5.2 (GND), U5.8 (STB), U5.9 (PAD)
