jayinfinia/archibald-moteus/hw/c1-encoder-review/current_sense.kicad_sch

## KiCad design hw/c1-encoder-review/current_sense.kicad_sch (2026-10-09)

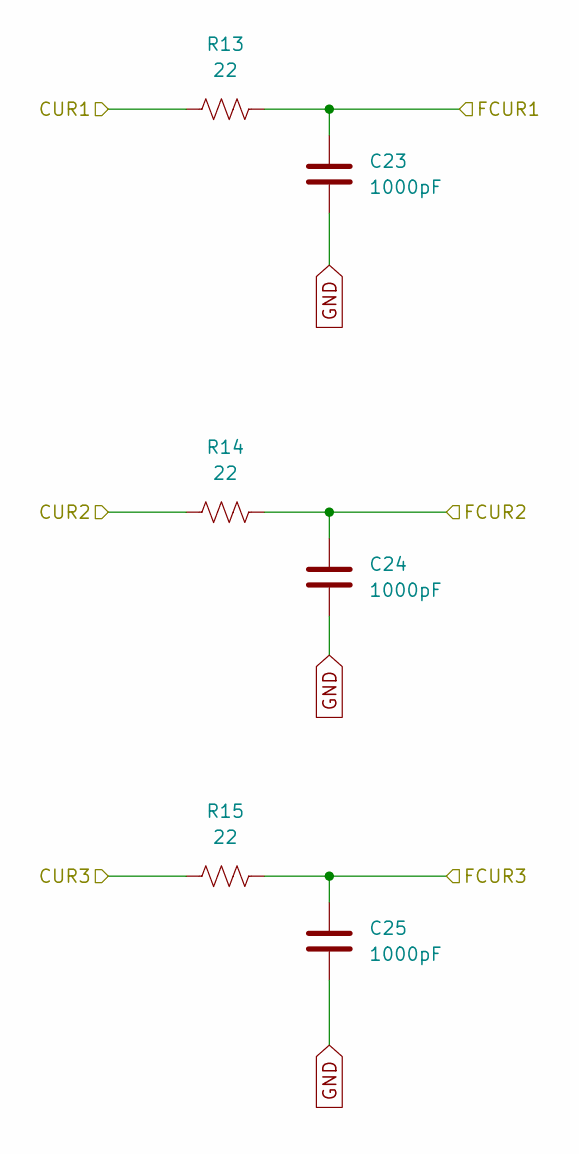
[picture p19: schematic current_sense.kicad_sch]

Parts:
C23, C24, C25: 1000pF; C_0402_1005Metric; MPN MF-CAP-0402-1nF
R13, R14, R15: 22; R_0402_1005Metric; MPN MF-RES-0402-22

Connections:
CUR1: R13.1
CUR2: R14.1
CUR3: R15.1
FCUR1: C23.1, R13.2
FCUR2: C24.1, R14.2
FCUR3: C25.1, R15.2
GND: C23.2, C24.2, C25.2
