jayinfinia/archibald-moteus/hw/c1-encoder-review/gate_driver.kicad_sch

## KiCad design hw/c1-encoder-review/gate_driver.kicad_sch (2026-10-09)

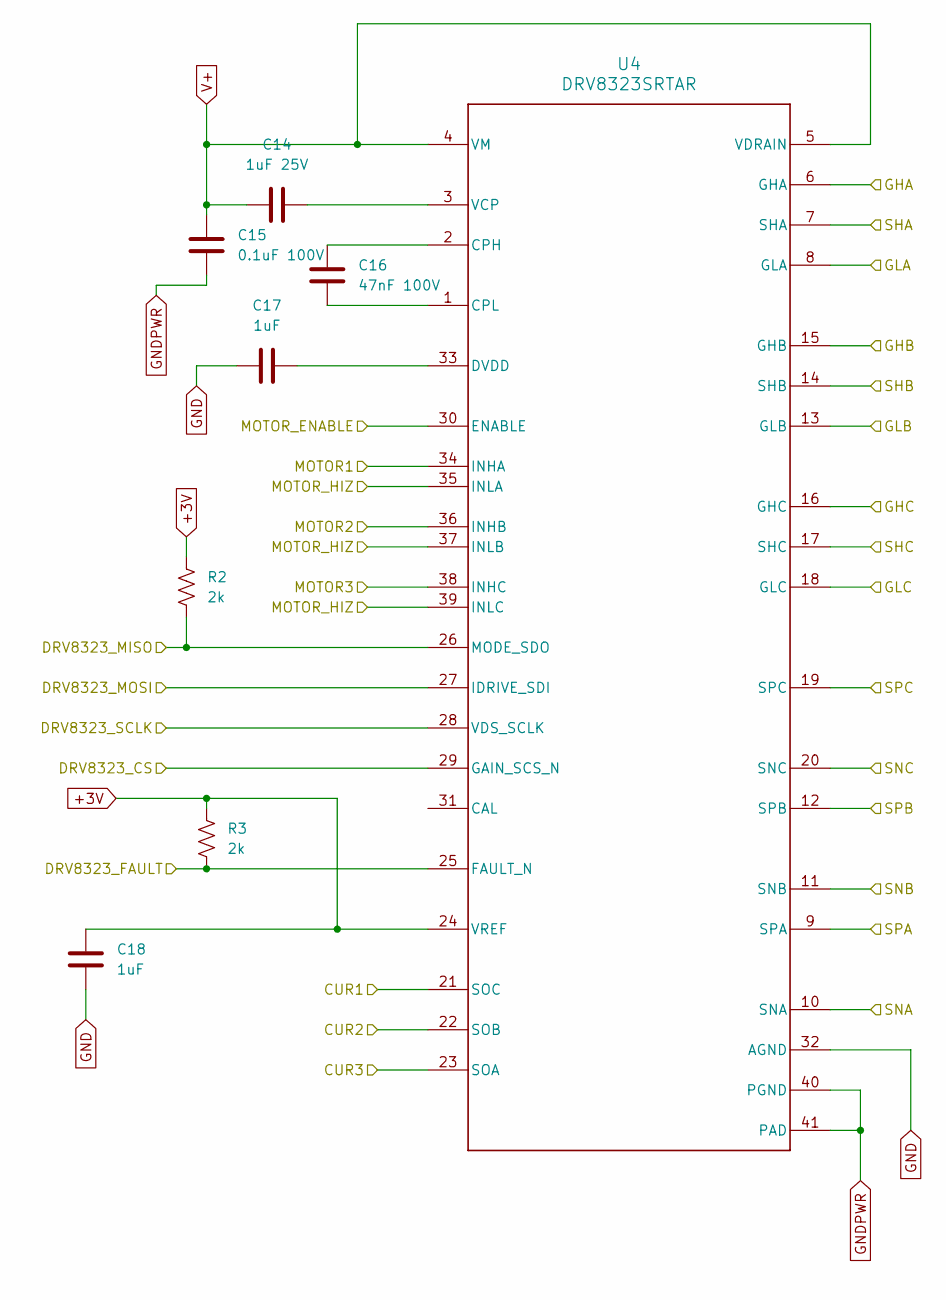
[picture p20: schematic gate_driver.kicad_sch]

Parts:
C14: 1uF 25V; C_0603_1608Metric; MPN C1608X7R1E105K080AE
C15: 0.1uF 100V; C_0603_1608Metric; MPN GCJ188R72A104KA01D
C16: 47nF 100V; C_0603_1608Metric; MPN C0603X473K1RAC7867
C17: 1uF; C_0402_1005Metric; MPN MF-CAP-0402-1uF
C18: 1uF; C_0603_1608Metric; MPN MF-CAP-0603-1uF
R2, R3: 2k; R_0402_1005Metric; MPN MF-RES-0402-2K
U4: DRV8323SRTAR; RTA0040B; MPN DRV8323SRTAR

Connections:
+3V: C18.2, R2.1, R3.1, U4.24 (VREF)
CUR1: U4.21 (SOC)
CUR2: U4.22 (SOB)
CUR3: U4.23 (SOA)
DRV8323_CS: U4.29 (GAIN_SCS_N)
DRV8323_FAULT: R3.2, U4.25 (FAULT_N)
DRV8323_MISO: R2.2, U4.26 (MODE_SDO)
DRV8323_MOSI: U4.27 (IDRIVE_SDI)
DRV8323_SCLK: U4.28 (VDS_SCLK)
GHA: U4.6 (GHA)
GHB: U4.15 (GHB)
GHC: U4.16 (GHC)
GLA: U4.8 (GLA)
GLB: U4.13 (GLB)
GLC: U4.18 (GLC)
GND: C17.1, C18.1, U4.32 (AGND)
GNDPWR: C15.1, U4.40 (PGND), U4.41 (PAD)
MOTOR1: U4.34 (INHA)
MOTOR2: U4.36 (INHB)
MOTOR3: U4.38 (INHC)
MOTOR_ENABLE: U4.30 (ENABLE)
MOTOR_HIZ: U4.35 (INLA), U4.37 (INLB), U4.39 (INLC)
unnamed: C14.2, U4.3 (VCP)
unnamed: C16.1, U4.1 (CPL)
unnamed: C16.2, U4.2 (CPH)
unnamed: C17.2, U4.33 (DVDD)
SHA: U4.7 (SHA)
SHB: U4.14 (SHB)
SHC: U4.17 (SHC)
SNA: U4.10 (SNA)
SNB: U4.11 (SNB)
SNC: U4.20 (SNC)
SPA: U4.9 (SPA)
SPB: U4.12 (SPB)
SPC: U4.19 (SPC)
V+: C14.1, C15.2, U4.4 (VM), U4.5 (VDRAIN)
