jayinfinia/archibald-moteus/hw/c1-encoder-review/h_bridge.kicad_sch

## KiCad design hw/c1-encoder-review/h_bridge.kicad_sch (2026-10-09)

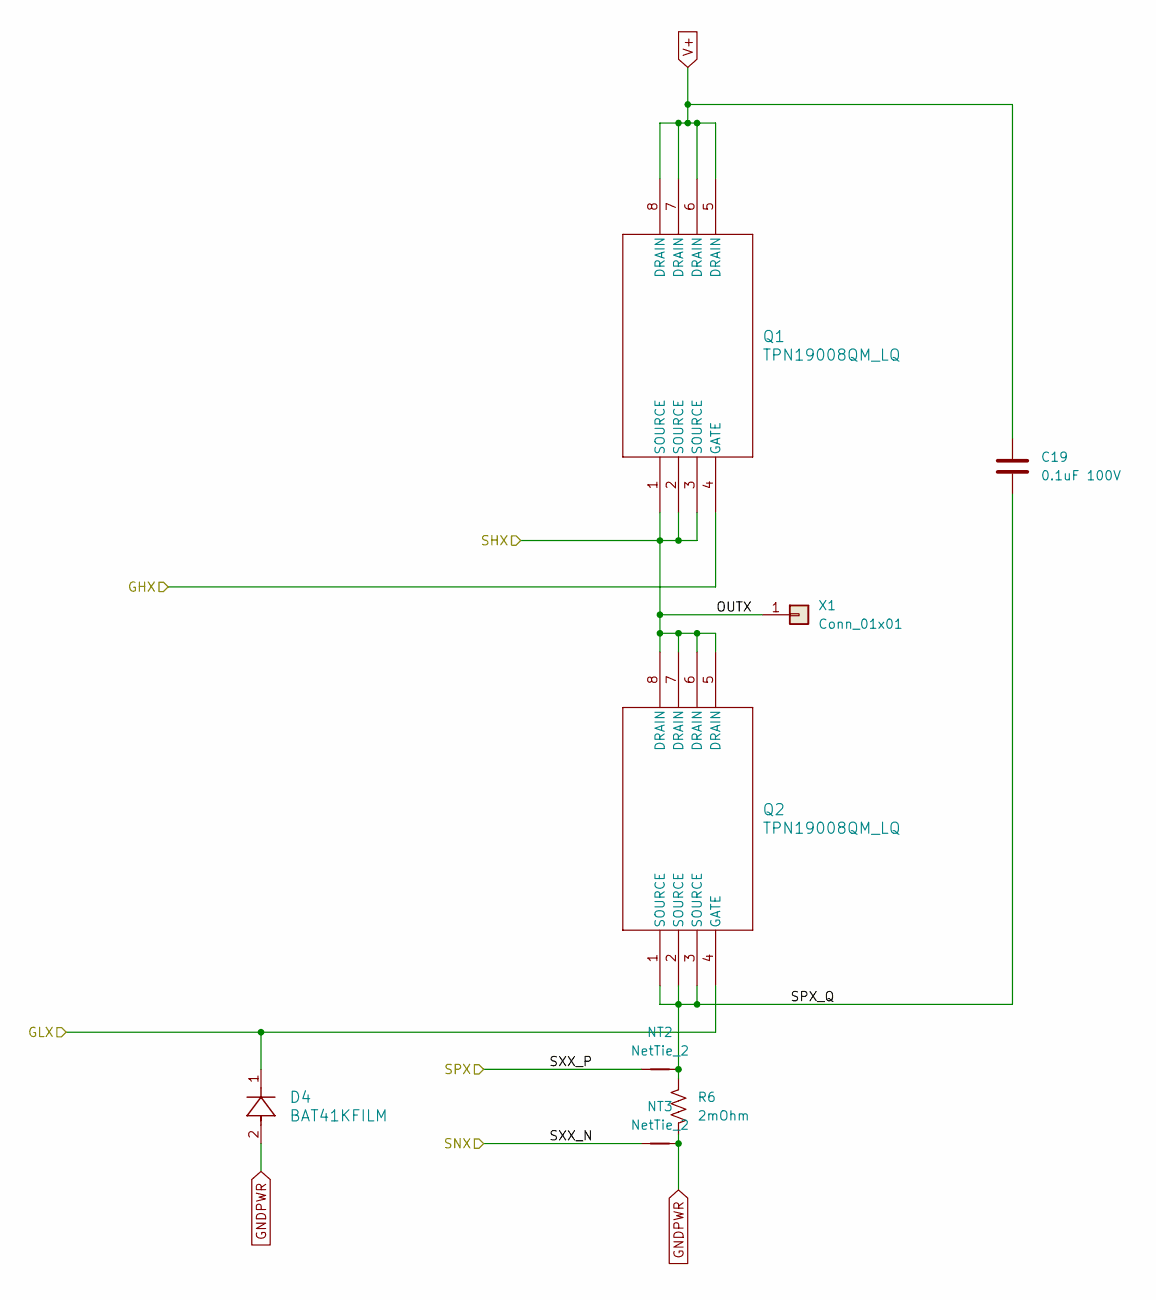
[picture p21: schematic h_bridge.kicad_sch]

Parts:
C19: 0.1uF 100V; C_1206_3216Metric; MPN 12061C104KAT2A
D4: BAT41KFILM; SOD-523_STM; MPN BAT41KFILM
NT2, NT3: NetTie_2; NetTie-2_SMD_Pad0.2
Q1, Q2: TPN19008QM_LQ; TSON Advance_TOS; MPN TPN19008QM,LQ
R6: 2mOhm; R_0805_2012Metric; MPN CSSH0805FT2L00
X1: Conn_01x01; POWER_M2.5

Connections:
GHX: Q1.4 (GATE)
GLX: D4.1, Q2.4 (GATE)
GNDPWR: D4.2, NT3.2, R6.2
OUTX: Q1.1 (SOURCE), Q1.2 (SOURCE), Q1.3 (SOURCE), Q2.5 (DRAIN), Q2.6 (DRAIN), Q2.7 (DRAIN), Q2.8 (DRAIN), X1.1
SNX: NT3.1
SPX: NT2.1
SPX_Q: C19.2, NT2.2, Q2.1 (SOURCE), Q2.2 (SOURCE), Q2.3 (SOURCE), R6.1
V+: C19.1, Q1.5 (DRAIN), Q1.6 (DRAIN), Q1.7 (DRAIN), Q1.8 (DRAIN)
