jayinfinia/archibald-moteus/hw/c1-encoder-review/led_sense.kicad_sch

## KiCad design hw/c1-encoder-review/led_sense.kicad_sch (2026-10-09)

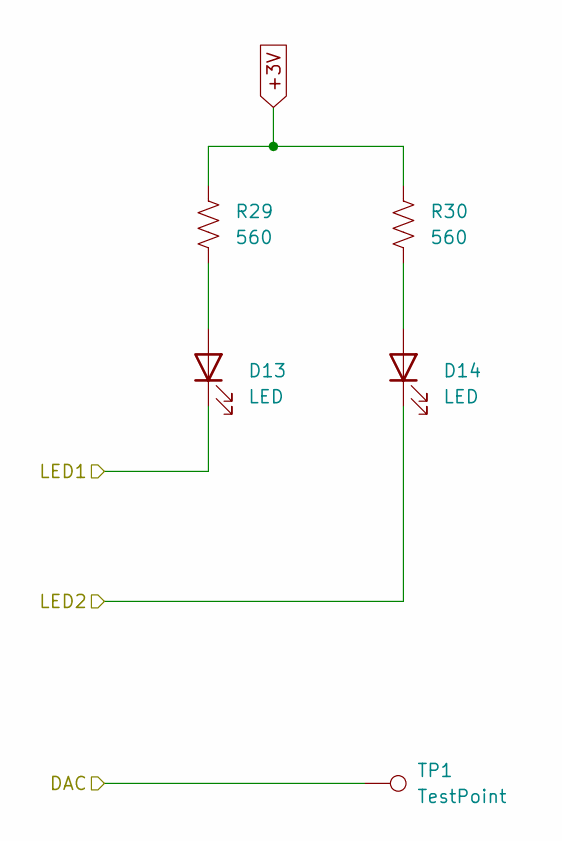
[picture p22: schematic led_sense.kicad_sch]

Parts:
D13: LED; LED_0603_1608Metric; MPN MF-LED-0603-RED
D14: LED; LED_0603_1608Metric; MPN MF-LED-0603-GREEN
R29, R30: 560; R_0402_1005Metric; MPN MF-RES-0402-560
TP1: TestPoint; TestPoint_THTPad_D1.0mm_Drill0.5mm

Connections:
+3V: R29.1, R30.1
DAC: TP1.1
LED1: D13.1 (K)
LED2: D14.1 (K)
unnamed: D13.2 (A), R29.2
unnamed: D14.2 (A), R30.2
