jayinfinia/archibald-moteus/hw/c1-encoder-review/power_input.kicad_sch

## KiCad design hw/c1-encoder-review/power_input.kicad_sch (2026-10-09)

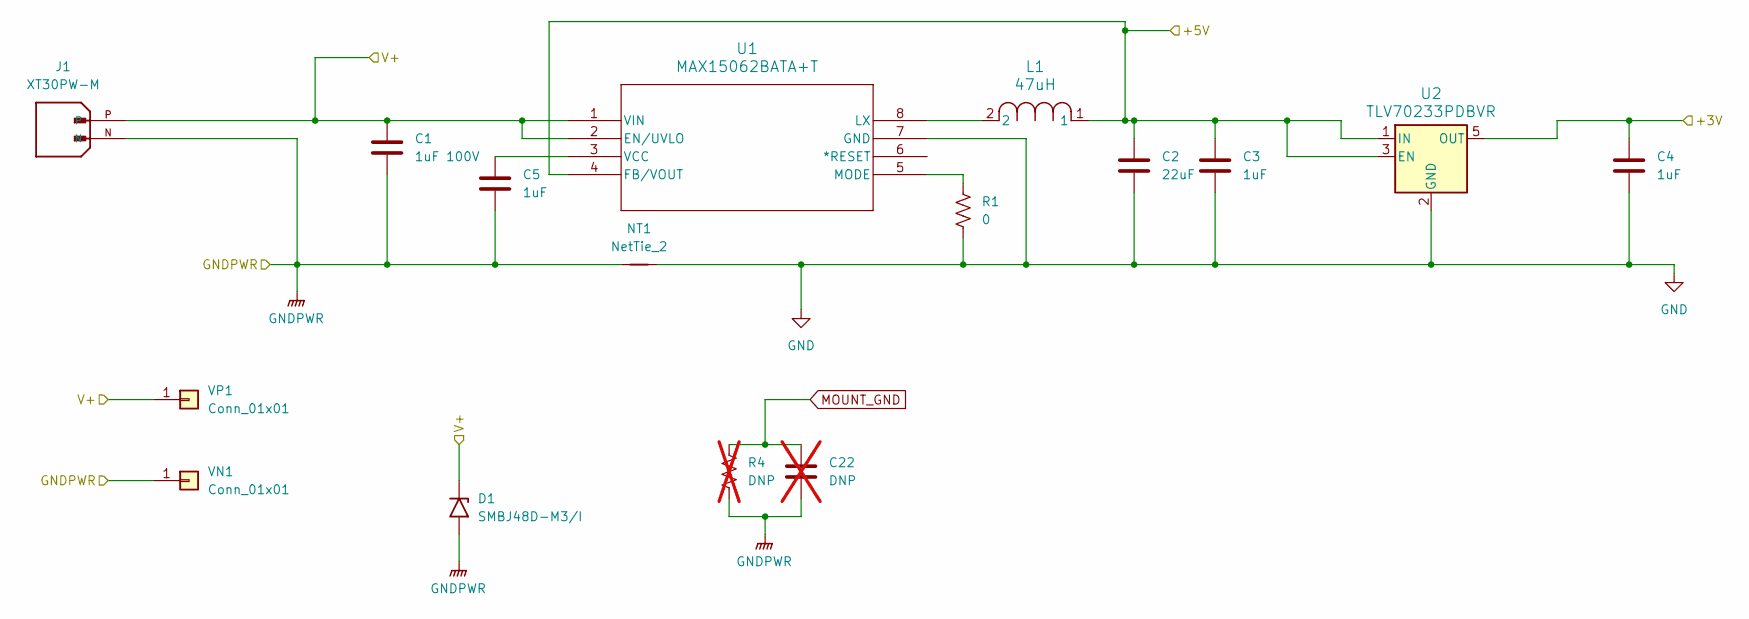
[picture p23: schematic power_input.kicad_sch]

Parts:
C1: 1uF 100V; C_0805_2012Metric; MPN GCM21BC72A105KE36L
C2: 22uF; C_1206_3216Metric; MPN GRM31CR71A226KE15L
C3, C4: 1uF; C_0402_1005Metric; MPN MF-CAP-0402-1uF
C5: 1uF; C_0603_1608Metric; MPN MF-CAP-0603-1uF
C22: DNP; C_0402_1005Metric; not fitted
D1: SMBJ48D-M3/I; D_SMB; MPN SMBJ48D-M3/I
J1: XT30PW-M; AMASS_XT30PW-M; MPN XT30PW-M
L1: 47uH; IND_4018-WE-LQS_WRE; MPN 74404042470
NT1: NetTie_2; NetTie-2_SMD_Pad0.254mm
R1: 0; R_0402_1005Metric; MPN MF-RES-0402-0
R4: DNP; R_0402_1005Metric; not fitted
U1: MAX15062BATA+T; 21-0487A_MXM; MPN MAX15062BATA+T
U2: TLV70233PDBVR; SOT-23-5; MPN TLV70233PDBVR
VN1: Conn_01x01; POWER_M2.5
VP1: Conn_01x01; POWER_M2.5

Connections:
+3V: C4.1, U2.5 (OUT)
+5V: C2.1, C3.1, L1.1, U1.4 (FB/VOUT), U2.1 (IN), U2.3 (EN)
GND: C2.2, C3.2, C4.2, NT1.2, R1.2, U1.7 (GND), U2.2 (GND)
GNDPWR: C1.2, C5.2, C22.2, D1.2 (A2), J1.N, NT1.1, R4.2, VN1.1
MOUNT_GND: C22.1, R4.1
unnamed: C5.1, U1.3 (VCC)
unnamed: L1.2, U1.8 (LX)
unnamed: R1.1, U1.5 (MODE)
V+: C1.1, D1.1 (A1), J1.P, U1.1 (VIN), U1.2 (EN/UVLO), VP1.1
