jayinfinia/archibald-moteus/hw/c1-encoder-review/stm32g4.kicad_sch

## KiCad design hw/c1-encoder-review/stm32g4.kicad_sch (2026-10-09)

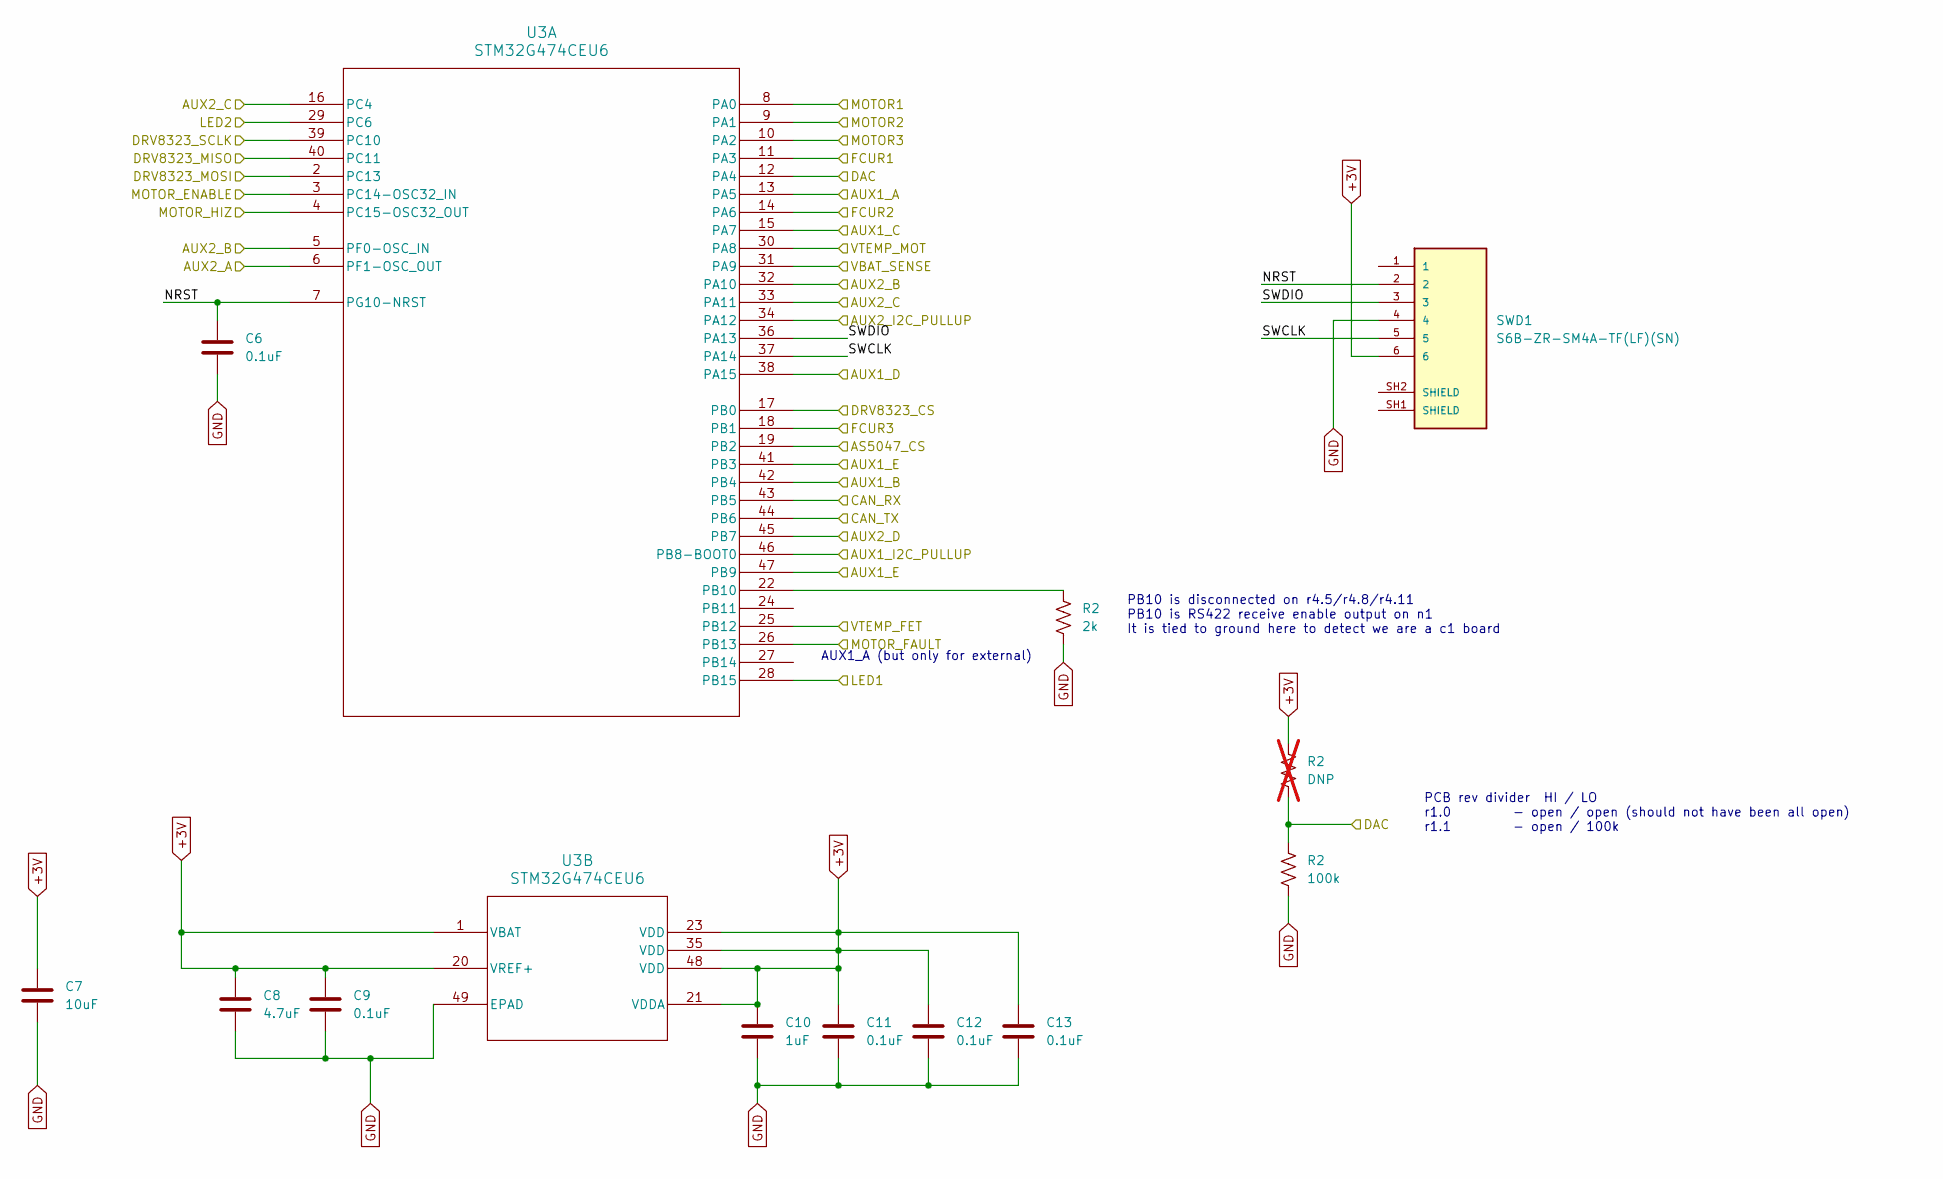
[picture p24: schematic stm32g4.kicad_sch]

Parts:
C6, C9, C11, C12, C13: 0.1uF; C_0402_1005Metric; MPN MF-CAP-0402-0.1uF
C7: 10uF; C_1206_3216Metric; MPN MF-CAP-1206-10uF
C8: 4.7uF; C_0603_1608Metric; MPN CL10A475KP8NNNC
C10: 1uF; C_0402_1005Metric; MPN MF-CAP-0402-1uF
R2: 2k; R_0402_1005Metric; MPN MF-RES-0402-2K
SWD1: S6B-ZR-SM4A-TF(LF)(SN); JST_S6B-ZR-SM4A-TF(LF)(SN); MPN S6B-ZR-SM4A-TF(LF)(SN)
U3: STM32G474CEU6; UFQFPN-48_7X7X0P55MM; MPN STM32G474CEU6

Connections:
+3V: C7.1, C8.1, C9.1, C10.1, C11.1, C12.1, C13.1, R2.1, SWD1.6, U3.1 (VBAT), U3.20 (VREF+), U3.21 (VDDA), U3.23 (VDD), U3.35 (VDD), U3.48 (VDD)
AS5047_CS: U3.19 (PB2)
AUX1_A: U3.13 (PA5)
AUX1_B: U3.42 (PB4)
AUX1_C: U3.15 (PA7)
AUX1_D: U3.38 (PA15)
AUX1_E: U3.41 (PB3), U3.47 (PB9)
AUX1_I2C_PULLUP: U3.46 (PB8-BOOT0)
AUX2_A: U3.6 (PF1-OSC_OUT)
AUX2_B: U3.5 (PF0-OSC_IN), U3.32 (PA10)
AUX2_C: U3.16 (PC4), U3.33 (PA11)
AUX2_D: U3.45 (PB7)
AUX2_I2C_PULLUP: U3.34 (PA12)
CAN_RX: U3.43 (PB5)
CAN_TX: U3.44 (PB6)
DAC: R2.1, R2.2, U3.12 (PA4)
DRV8323_CS: U3.17 (PB0)
DRV8323_MISO: U3.40 (PC11)
DRV8323_MOSI: U3.2 (PC13)
DRV8323_SCLK: U3.39 (PC10)
FCUR1: U3.11 (PA3)
FCUR2: U3.14 (PA6)
FCUR3: U3.18 (PB1)
GND: C6.2, C7.2, C8.2, C9.2, C10.2, C11.2, C12.2, C13.2, R2.2, SWD1.4, U3.49 (EPAD)
LED1: U3.28 (PB15)
LED2: U3.29 (PC6)
MOTOR1: U3.8 (PA0)
MOTOR2: U3.9 (PA1)
MOTOR3: U3.10 (PA2)
MOTOR_ENABLE: U3.3 (PC14-OSC32_IN)
MOTOR_FAULT: U3.26 (PB13)
MOTOR_HIZ: U3.4 (PC15-OSC32_OUT)
NRST: C6.1, SWD1.2, U3.7 (PG10-NRST)
unnamed: R2.1, U3.22 (PB10)
SWCLK: SWD1.5, U3.37 (PA14)
SWDIO: SWD1.3, U3.36 (PA13)
VBAT_SENSE: U3.31 (PA9)
VTEMP_FET: U3.25 (PB12)
VTEMP_MOT: U3.30 (PA8)

Notes on the sheet:
PB10 is disconnected on r4.5/r4.8/r4.11 PB10 is RS422 receive enable output on n1 It is tied to ground here to detect we are a c1 board
PCB rev divider HI / LO r1.0 - open / open (should not have been all open) r1.1 - open / 100k
AUX1_A (but only for external)
