jayinfinia/archibald-moteus/hw/c1-encoder-review/vt_sense.kicad_sch

## KiCad design hw/c1-encoder-review/vt_sense.kicad_sch (2026-10-09)

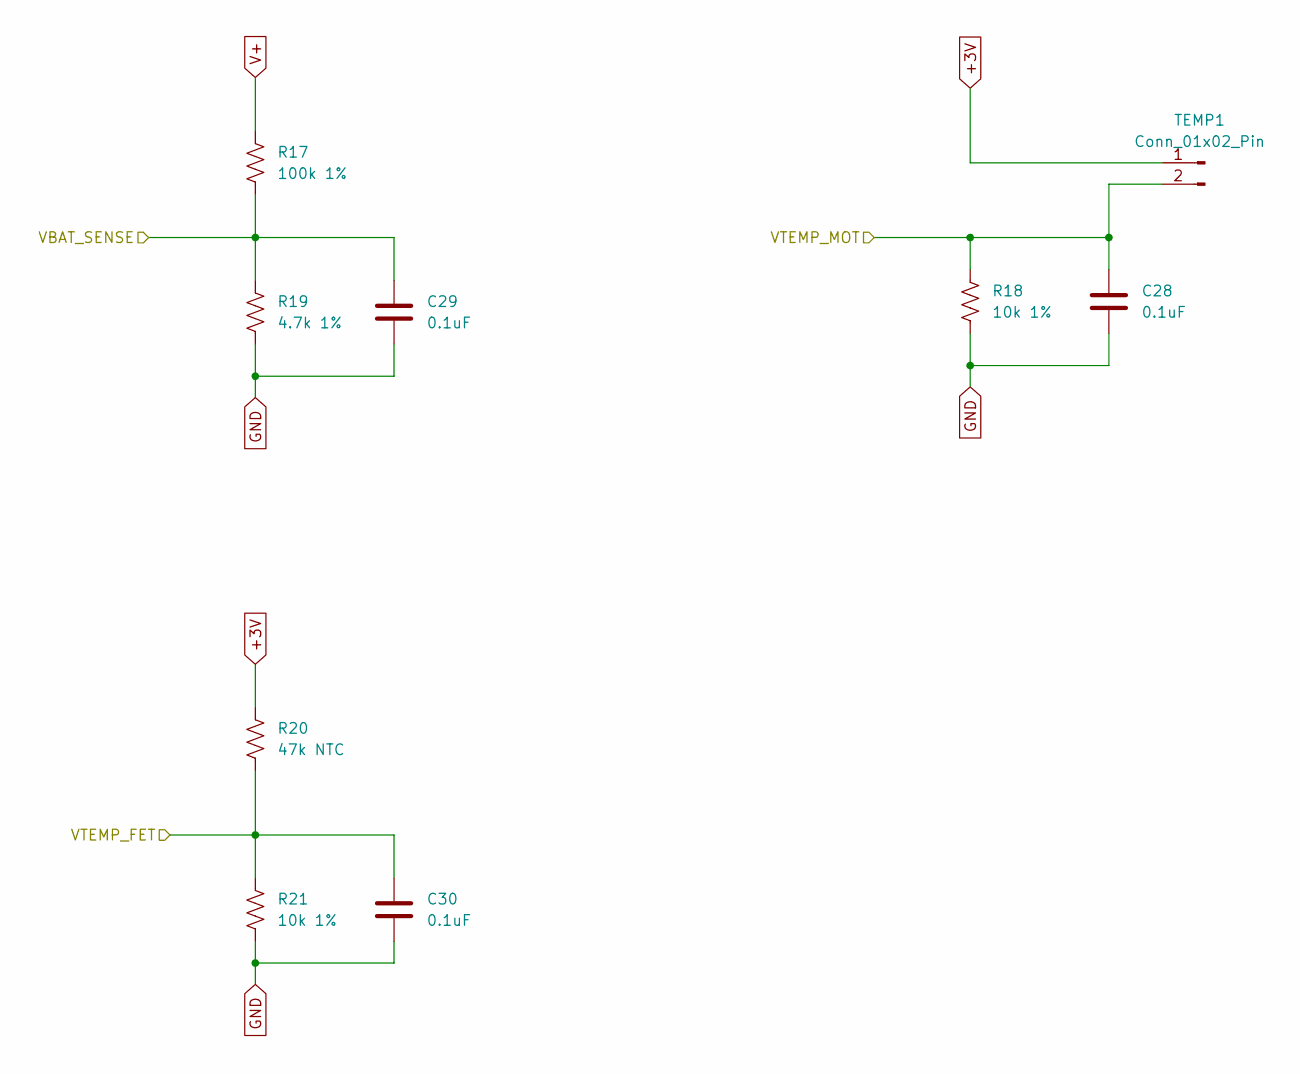
[picture p25: schematic vt_sense.kicad_sch]

Parts:
C28, C29, C30: 0.1uF; C_0402_1005Metric; MPN MF-CAP-0402-0.1uF
R17: 100k 1%; R_0402_1005Metric; MPN RC0402FR-07100KL
R18, R21: 10k 1%; R_0402_1005Metric; MPN RC0402FR-0710KL
R19: 4.7k 1%; R_0402_1005Metric; MPN RC0402FR-074K7L
R20: 47k NTC; R_0402_1005Metric; MPN NCP15WB473F03RC
TEMP1: Conn_01x02_Pin; PinHeader_1x02_P2.00mm_Vertical

Connections:
+3V: R20.1, TEMP1.1
GND: C28.2, C29.2, C30.2, R18.2, R19.2, R21.2
V+: R17.1
VBAT_SENSE: C29.1, R17.2, R19.1
VTEMP_FET: C30.1, R20.2, R21.1
VTEMP_MOT: C28.1, R18.1, TEMP1.2
