jayinfinia/archibald-moteus/(commit log)

2026-10-09 Add integrated C1 encoder schematic review variant and validation suite
    [Bench-Test-Record.csv, aux1.kicad_sch, aux2.kicad_sch, bulk_capacitance.kicad_sch, can.kicad_sch, current_sense.kicad_sch, gate_driver.kicad_sch, h_bridge.kicad_sch]
2026-10-19 Refresh schematic validation results for review
2026-10-19 Add TI transceiver footprint and conditional loaded power budget
    [aux2.kicad_sch]
